sourcebots/kit-manufacture-2019/quote-pack/motor/motor-coords.txt

Filename: ...

Position of PCB:
left under edge: X=0 / Y=0

name	X-axis	Y-axis	angle	value	package	side
D12	30.62	70.05	0	gsot24c	SOT23	top
D11	41.48	70.05	180	gsot24c	SOT23	top
DS9	16.10	71.75	180	redblue-dual	0805_split_led	top
DS8	55.90	71.75	180	redblue-dual	0805_split_led	top
DS7	36.05	54.60	0	redgreen-0805	0805_led	top
R35	52.00	70.90	0	10k	0603	top
R21	31.50	54.65	180	1k-1206	1206	top
R53	12.70	71.15	180	1k-1206	1206	top
R37	59.30	71.15	0	1k-1206	1206	top
J7	22.90	74.00	180	camcon2w-5mm	camcon_50_2	top
J6	49.10	74.00	180	camcon2w-5mm	camcon_50_2	top
C39	16.00	42.00	270	pcf1c221mcl1gs	NICHICON_CAP_10_10	top
C37	44.00	42.00	270	pcf1c221mcl1gs	NICHICON_CAP_10_10	top
Q2	36.33	50.36	0	n-irfh5301	PQFN56B	top
C32	37.00	46.45	0	100n-0603-50v	0603	top
C40	28.00	42.00	270	pcf1c221mcl1gs	NICHICON_CAP_10_10	top
C38	56.00	42.00	270	pcf1c221mcl1gs	NICHICON_CAP_10_10	top
C31	36.00	67.15	180	100n-0603-50v	0603	top
L11	36.00	61.10	270	20a-170r	CM3440Z171B	top
J5	36.00	74.00	180	camcon2w	camcon_75_2	top
U6	20.00	60.09	90	vnh5019	MultiPowerSO30	top
U5	52.00	60.09	90	vnh5019	MultiPowerSO30	top
D10	26.53	16.85	180	gsot05c	SOT23	top
J2	29.59	21.08	270	header2x4-std	header_254_8w	top
DS2	41.80	64.35	90	red-0805	0805_led	top
DS3	41.80	59.00	90	blue-0805	0805_led	top
DS4	30.20	64.35	90	red-0805	0805_led	top
DS5	30.20	59.00	90	blue-0805	0805_led	top
S1	56.90	28.40	180	button-ra	FSMRA2JH	top
R13	16.15	35.30	180	10k-0402	0402	top
R16	26.05	29.10	270	10k-0402	0402	top
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
R15	30.50	16.50	270	4k7-0402	0402	top
L10	28.50	16.50	90	200m-1k-0402	0402	top
VR1	47.15	17.75	270	82400102	SOT26	top
R12	44.25	19.95	180	330-0402	0402	top
DS6	44.25	17.70	270	red-0805	0805_led	top
R1	42.25	19.95	180	330-0402	0402	top
DS1	42.25	17.70	270	green-0805	0805_led	top
C9	54.60	16.45	270	100n-0402-16v	0402	top
C20	53.60	16.45	270	100n-0402-16v	0402	top
C18	50.60	16.45	90	100n-0402-16v	0402	top
L3	49.60	16.45	270	200m-1k-0402	0402	top
R10	52.60	16.45	270	10k-0402	0402	top
R5	51.60	16.45	90	4k7-0402	0402	top
R38	40.80	28.10	0	10k-0402	0402	top
R40	40.80	32.20	180	4k7-0402	0402	top
R43	40.80	33.40	0	1k-0402	0402	top
R45	40.80	31.00	180	4k7-0402	0402	top
R46	40.80	29.80	0	1k-0402	0402	top
R24	40.80	25.70	180	4k7-0402	0402	top
R27	40.80	26.90	0	1k-0402	0402	top
R29	40.80	24.50	180	4k7-0402	0402	top
R30	40.80	23.30	0	1k-0402	0402	top
R54	40.80	34.60	0	10k-0402	0402	top
Y1	28.95	26.00	270	abmm2-8.000mhz-e2-t	ABMM2	top
J4	15.57	19.46	90	header2x5-1.27mm	header_127_10w	top
J1	46.00	13.01	270	usb-micro-b	FCI_10103592	top
FID1	11.00	17.00	0	unknown	FIDUCIAL	top
FID2	55.60	79.20	0	unknown	FIDUCIAL	top
