sourcebots/kit-manufacture-2019/quote-pack/motor/motor-coords-raw.txt

# PcbXY Version 1.0
# Date: Wed 10 Jul 2019 18:34:43 GMT UTC
# Author: Kier Davis
# Title: (unknown) - PCB X-Y
# RefDes, Description, Value, X, Y, rotation, top/bottom
# X,Y in mm.  rotation in degrees.
# --------------------------------------------
D12,"SOT23_sr.fp","sr-d-gsot24c",30.62,70.05,0,top
D11,"SOT23_sr.fp","sr-d-gsot24c",41.48,70.05,180,top
DS9,"0805_split_led_sr.fp","sr-led-redblue-dual",16.10,71.75,180,top
DS8,"0805_split_led_sr.fp","sr-led-redblue-dual",55.90,71.75,180,top
DS7,"0805_led_sr.fp","sr-led-redgreen-0805",36.05,54.60,0,top
R35,"0603_sr.fp","sr-r-10k",52.00,70.90,0,top
R21,"1206_sr.fp","sr-r-1k-1206",31.50,54.65,180,top
R53,"1206_sr.fp","sr-r-1k-1206",12.70,71.15,180,top
R37,"1206_sr.fp","sr-r-1k-1206",59.30,71.15,0,top
J7,"camcon_50_2_sr.fp","sr-cn-camcon2w-5mm",22.90,74.00,180,top
J6,"camcon_50_2_sr.fp","sr-cn-camcon2w-5mm",49.10,74.00,180,top
C39,"NICHICON_CAP_10_10_sr.fp","sr-c-pcf1c221mcl1gs",16.00,42.00,270,top
C37,"NICHICON_CAP_10_10_sr.fp","sr-c-pcf1c221mcl1gs",44.00,42.00,270,top
Q2,"PQFN56B_sr.fp","sr-fet-n-irfh5301",36.33,50.36,0,top
C32,"0603_sr.fp","sr-c-100n-0603-50v",37.00,46.45,0,top
C40,"NICHICON_CAP_10_10_sr.fp","sr-c-pcf1c221mcl1gs",28.00,42.00,270,top
C38,"NICHICON_CAP_10_10_sr.fp","sr-c-pcf1c221mcl1gs",56.00,42.00,270,top
C31,"0603_sr.fp","sr-c-100n-0603-50v",36.00,67.15,180,top
L11,"CM3440Z171B_sr.fp","sr-cm-20a-170r",36.00,61.10,270,top
J5,"camcon_75_2_sr.fp","sr-cn-camcon2w",36.00,74.00,180,top
U6,"MultiPowerSO30_sr.fp","sr-ic-vnh5019",20.00,60.09,90,top
U5,"MultiPowerSO30_sr.fp","sr-ic-vnh5019",52.00,60.09,90,top
D10,"SOT23_sr.fp","sr-d-gsot05c",26.53,16.85,180,top
J2,"header_254_8w_sr.fp","sr-cn-header2x4-std",29.59,21.08,270,top
DS2,"0805_led_sr.fp","sr-led-red-0805",41.80,64.35,90,top
DS3,"0805_led_sr.fp","sr-led-blue-0805",41.80,59.00,90,top
DS4,"0805_led_sr.fp","sr-led-red-0805",30.20,64.35,90,top
DS5,"0805_led_sr.fp","sr-led-blue-0805",30.20,59.00,90,top
S1,"FSMRA2JH_sr.fp","sr-sw-button-ra",56.90,28.40,180,top
R13,"0402_sr.fp","sr-r-10k-0402",16.15,35.30,180,top
R16,"0402_sr.fp","sr-r-10k-0402",26.05,29.10,270,top
C28,"0402_sr.fp","sr-c-100n-0402-16v",25.05,28.40,90,top
U4,"LQFP64_10_sr.fp","sr-ic-stm32f100r6",17.90,28.10,180,top
J3,"camcon_38_4_sr.fp","sr-cn-minicamcon4w",26.00,14.00,90,top
C35,"0603_sr.fp","sr-c-100n-0603-50v",25.80,48.95,0,top
C36,"1206_sr.fp","sr-c-10u-1206-16v",30.05,51.15,90,top
C33,"0603_sr.fp","sr-c-100n-0603-50v",57.80,48.95,0,top
C34,"1206_sr.fp","sr-c-10u-1206-16v",41.80,51.15,90,top
C48,"0603_sr.fp","sr-c-100n-0603-50v",24.00,70.90,0,top
R51,"0603_sr.fp","sr-r-10k",20.00,70.90,0,top
C44,"0603_sr.fp","sr-c-100n-0603-50v",48.00,70.90,0,top
D15,"SOT23_sr.fp","sr-d-bat754a",36.00,39.08,270,top
R58,"0402_sr.fp","sr-r-10k-0402",34.50,46.70,0,top
R59,"0402_sr.fp","sr-r-10k-0402",37.00,41.25,0,top
Q3,"SOT23_sr.fp","sr-npn-bc846b",36.00,44.08,270,top
R60,"0402_sr.fp","sr-r-10k-0402",35.00,41.25,0,top
U3,"QFN32_5_EP_sr.fp","sr-ic-ft232rq",54.85,20.50,270,top
C1,"0805_sr.fp","sr-c-4u7-0805-10v",59.85,17.95,180,top
C19,"0603_sr.fp","sr-c-47n-0603-50v",52.15,11.85,270,top
R9,"0402_sr.fp","sr-r-1000k-0402",52.15,14.35,90,top
C11,"0402_sr.fp","sr-c-100n-0402-16v",51.35,18.35,270,top
C7,"0402_sr.fp","sr-c-100n-0402-16v",59.10,22.95,0,top
C21,"0402_sr.fp","sr-c-100n-0402-16v",19.20,16.35,270,top
L6,"0402_sr.fp","sr-fb-200m-1k-0402",18.20,16.35,90,top
F1,"1206_sr.fp","sr-fuse-r50-1206",22.10,16.35,0,top
D2,"SOD123_sr.fp","sr-d-mmsz4689t1g",54.05,12.70,270,top
D1,"SOT23_sr.fp","sr-d-bat754c",59.52,20.60,0,top
C13,"0402_sr.fp","sr-c-100n-0402-16v",35.70,10.85,0,top
C17,"0402_sr.fp","sr-c-10n-0402-25v",49.90,17.90,0,top
Q1,"SOT23_sr.fp","sr-npn-bc846b",59.62,34.05,0,top
C26,"0603_sr.fp","sr-c-470n-0603-25v",57.45,34.15,90,top
C12,"0805_sr.fp","sr-c-4u7-0805-10v",23.40,19.25,270,top
C10,"0402_sr.fp","sr-c-100n-0402-16v",21.90,20.10,270,top
C8,"0402_sr.fp","sr-c-100n-0402-16v",10.70,23.65,90,top
C6,"0402_sr.fp","sr-c-100n-0402-16v",14.25,35.30,0,top
C5,"0402_sr.fp","sr-c-100n-0402-16v",20.45,35.30,0,top
C16,"0603_sr.fp","sr-c-1u-0603-16v",26.05,33.55,90,top
C15,"0402_sr.fp","sr-c-100n-0402-16v",25.05,30.30,270,top
L5,"0402_sr.fp","sr-fb-200m-1k-0402",39.50,20.05,0,top
L4,"0402_sr.fp","sr-fb-200m-1k-0402",37.60,20.05,0,top
C14,"0402_sr.fp","sr-c-100n-0402-16v",35.70,20.05,0,top
C29,"0402_sr.fp","sr-c-27p-0402-50v",32.85,26.65,270,top
C30,"0402_sr.fp","sr-c-27p-0402-50v",25.05,24.60,270,top
R17,"0402_sr.fp","sr-r-100-0402",25.05,26.50,270,top
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
R38,"0402_sr.fp","sr-r-10k-0402",40.80,28.10,0,top
R40,"0402_sr.fp","sr-r-4k7-0402",40.80,32.20,180,top
R43,"0402_sr.fp","sr-r-1k-0402",40.80,33.40,0,top
R45,"0402_sr.fp","sr-r-4k7-0402",40.80,31.00,180,top
R46,"0402_sr.fp","sr-r-1k-0402",40.80,29.80,0,top
R24,"0402_sr.fp","sr-r-4k7-0402",40.80,25.70,180,top
R27,"0402_sr.fp","sr-r-1k-0402",40.80,26.90,0,top
R29,"0402_sr.fp","sr-r-4k7-0402",40.80,24.50,180,top
R30,"0402_sr.fp","sr-r-1k-0402",40.80,23.30,0,top
R54,"0402_sr.fp","sr-r-10k-0402",40.80,34.60,0,top
Y1,"ABMM2_sr.fp","sr-xtal-abmm2-8.000mhz-e2-t",28.95,26.00,270,top
J4,"header_127_10w_sr.fp","sr-cn-header2x5-1.27mm",15.57,19.46,90,top
J1,"FCI_10103592_sr.fp","sr-cn-usb-micro-b",46.00,13.01,270,top
FID1,"FIDUCIAL_sr.fp","unknown",11.00,17.00,0,top
FID2,"FIDUCIAL_sr.fp","unknown",55.60,79.20,0,top
