sourcebots/kit-manufacture-2019/quote-pack/motor/motor.txt

## Specifications ##

Substrate: 1.6mm FR4
Num layers: 4
Copper weight: 1oz
Finish: HASL
Soldermask: top and bottom
Soldermask colour: green
Silkscreen: top and bottom
Silkscreen colour: white
Quantity: 16 boards
Dimensions: 52mm x 70mm

Layer stackup:
  Top (motor.top.gbr)
  Inner 1 (motor.group2.gbr)
  Inner 2 (motor.group3.gbr)
  Bottom (motor.bottom.gbr)

Number of surface mount components: 156
Number of through-hole components: 8

Number of types of component / BOM lines: 59

## Components Of Note ##

D14, R2, R3, R11: do not populate (unused)
