sourcebots/kit-manufacture-2019/quote-pack/servo/servo.txt

## Specifications ##

Substrate: 1.6mm FR4
Num layers: 4
Copper weight: 1oz
Finish: HASL
Soldermask: top and bottom
Soldermask colour: green
Silkscreen: top and bottom
Silkscreen colour: white
Quantity: 25 boards
Dimensions: 50mm x 51mm

Layer stackup:
  Top (servo.top.gbr)
  Inner 1 (servo.group2.gbr)
  Inner 2 (servo.group3.gbr)
  Bottom (servo.bottom.gbr)

Number of surface mount components: 139
Number of through-hole components: 7

Number of types of component / BOM lines: 55

## Components Of Note ##

N/A
