sourcebots/kit-manufacture-2019/quote-pack/servo/servo-bom.xlsx

Part | Value | Device | Package | Description | Description2 | Qty | Place_YES/NO | Provided_by_customer_YES/NO | Distributor | Ordernumber | Weblink | Remarks_customer | Unit_price | Total_price | REMARKS_BETA | OPTION1 | OPTION2 | OPTION3
C19, C4, C5, C8, C7, C38, C31, C40, C12, C18, C39, C32, C3 | 100n-0402-16v | sr-c-100n-0402-16v | 0402 | SMD Capacitor, 100nF, 10%, 16V, 0402 |  | 13 | YES | NO | beta
C21, C34, C14 | 100n-0603-50v | sr-c-100n-0603-50v | 0603 | SMD Capacitor, 100nF, 10%, 50V, 0603 |  | 3 | YES | NO | beta
C11 | 10n-0402-25v | sr-c-10n-0402-25v | 0402 | SMD Capacitor, 10nF, 10%, 25V, 0402 |  | 1 | YES | NO | beta
C9, C30, C10, C35 | 1n5-0402-50v | sr-c-1n5-0402-50v | 0402 | 1n5 capacitor 0402 50V X7R |  | 4 | YES | NO | farnell | 1758993 | https://uk.farnell.com/-/-/-/dp/1758993
C13, C1, C37, C2, C22 | 1u-0402-10v | sr-c-1u-0402-10v | 0402 | 1u capacitor 0402 10V X5R |  | 5 | YES | NO | farnell | 1458896 | https://uk.farnell.com/-/-/-/dp/1458896
C20 | 1u-0603-16v | sr-c-1u-0603-16v | 0603 | SMD Capacitor, 1uF, 10%, 16V, 0603 |  | 1 | YES | NO | beta
C44, C43, C6 | 22u-0805-10v | sr-c-22u-0805-10v | 0805 | 22u capacitor 0805 10V X5R |  | 3 | YES | NO | farnell | 2611932 | https://uk.farnell.com/-/-/-/dp/2611932
C42, C33, C41, C25, C23, C24 | 22u-1210-16v | sr-c-22u-1210-16v | 1210 | 22u ceramic capacitor 1210 16V X5R |  | 6 | YES | NO | farnell | 1759466 | https://uk.farnell.com/-/-/-/dp/1759466
C15, C16 | 27p-0402-50v | sr-c-27p-0402-50v | 0402 | 27p capacitor 0402 50V C0G/NP0 |  | 2 | YES | NO | farnell | 1414584 | https://uk.farnell.com/-/-/-/dp/1414584
C17 | 470n-0603-25v | sr-c-470n-0603-25v | 0603 | 470n capacitor 0603 25V X7R |  | 1 | YES | NO | farnell | 1856365 | https://uk.farnell.com/-/-/-/dp/1856365
C26, C29, C28, C27 | 47u-1206-6v3 | sr-c-47u-1206-6v3 | 1206 | 47u ceramic capacitor 1206 6.3V X5R |  | 4 | YES | NO | mouser | 81-GRT31CR61A476KE3L | https://www.mouser.co.uk/ProductDetail/Murata-Electronics/GRT31CR61A476KE13L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
J4 | camcon2w | sr-cn-camcon2w | camcon_75_2 | Pluggable terminal block 2way 7.5mm pitch male horiz |  | 1 | YES | NO | farnell | 3882391 | https://uk.farnell.com/-/-/-/dp/3882391
J5 | camcon2w-5mm | sr-cn-camcon2w-5mm | camcon_50_2 | Pluggable terminal block 2way 5mm pitch male horiz |  | 1 | YES | NO | farnell | 3882093 | https://uk.farnell.com/-/-/-/dp/3882093
J3 | header2x5-1.27mm | sr-cn-header2x5-1.27mm | header_127_10w | 2x5 through-hole 1.27mm header 3mm pin length |  | 1 | YES | NO | farnell | 1577743 | https://uk.farnell.com/-/-/-/dp/1577743
J6 | header3x4-ra | sr-cn-header3x4-ra | header_254_3_12w | 3x4 through-hole 2.54mm right angle header |  | 1 | YES | NO | farnell | 2053141 | https://uk.farnell.com/-/-/-/dp/2053141
J7 | header3x8-ra | sr-cn-header3x8-ra | header_254_3_24w | 3x8 through-hole 2.54mm right angle header |  | 1 | YES | NO | farnell | 2053145 | https://uk.farnell.com/-/-/-/dp/2053145
J1 | minicamcon4w | sr-cn-minicamcon4w | camcon_38_4 | Pluggable terminal block 4way 3.81mm pitch male horiz |  | 1 | YES | NO | farnell | 1717073 | https://uk.farnell.com/-/-/-/dp/1717073
J2 | usb-micro-b | sr-cn-usb-micro-b | FCI_10103592 | Micro USB B connector for top mounting |  | 1 | YES | NO | farnell | 2490660 | https://uk.farnell.com/-/-/-/dp/2490660
D2 | 1sma5918bt3g | sr-d-1sma5918bt3g | DO214AC | zener diode 5.1V 1.5W |  | 1 | YES | NO | farnell | 1431140 | https://uk.farnell.com/-/-/-/dp/1431140
D4, D1 | bat54c | sr-d-bat54c | SOT23 | schottky diode 30V 300mA dual common cathode |  | 2 | YES | NO | farnell | 9801499 | https://uk.farnell.com/-/-/-/dp/9801499
D7, D9, D10 | edz51v | sr-d-edz51v | SOD523 | zener diode 5.1V 150mW |  | 3 | YES | NO | farnell | 2536475 | https://uk.farnell.com/-/-/-/dp/2536475
D15, D13, D18, D3, D14, D17, D12 | mmbz15val | sr-d-mmbz15val | SOT23 | 12V unidirectional dual TVS diode 40W common anode |  | 7 | YES | NO | farnell | 1829193 | https://uk.farnell.com/-/-/-/dp/1829193
D11, D5, D16 | pesd5z12 | sr-d-pesd5z12 | SOD523 | 12V unidirectional TVS diode 200W |  | 3 | YES | NO | farnell | 1829227 | https://uk.farnell.com/-/-/-/dp/1829227
D6, D8 | smaj15ca | sr-d-smaj15ca | DO214AC | 15V bidirectional TVS diode 400W |  | 2 | YES | NO | farnell | 9802789 | https://uk.farnell.com/-/-/-/dp/9802789
L2, L4, L3 | 200m-1k-0402 | sr-fb-200m-1k-0402 | 0402 | 200mA 1k @ 100MHz 0402 |  | 3 | YES | NO | farnell | 1669673 | https://uk.farnell.com/-/-/-/dp/1669673
L1, L5 | 300m-0603 | sr-fb-300m-0603 | 0603 | 300mA 1k @ 100MHz 0603 |  | 2 | YES | NO | farnell | 1463451 | https://uk.farnell.com/-/-/-/dp/1463451
Q6 | n-bsh121 | sr-fet-n-bsh121 | SOT323 | BSH121 n-channel mosfet very low Vt of 1V |  | 1 | YES | NO | farnell | 2053836 | https://uk.farnell.com/-/-/-/dp/2053836
Q4, Q5, Q3, Q2 | p-si7655adn | sr-fet-p-si7655adn | PowerPAK1212 | p-channel mosfet 20V 30A |  | 4 | YES | NO | farnell | 2400368 | https://uk.farnell.com/-/-/-/dp/2400368
F1 | r200-1206 | sr-fuse-r200-1206 | 1206 | 200mA 30V resettable fuse |  | 1 | YES | NO | farnell | 1206716 | https://uk.farnell.com/-/-/-/dp/1206716
U6 | ina219 | sr-ic-ina219 | SOT28 | INA219AIDCNR I2C current sense amp |  | 1 | YES | NO | farnell | 3118164 | https://uk.farnell.com/-/-/-/dp/3118164
U1 | mcp1700t3302emb | sr-ic-mcp1700t3302emb | SOT89 | 3.3V 250mA (6V Vin max) linear voltage reg |  | 1 | YES | NO | farnell | 1439380 | https://uk.farnell.com/-/-/-/dp/1439380
U4 | mcp1703t5002emb | sr-ic-mcp1703t5002emb | SOT89 | 5V 250mA (16V Vin max) linear voltage reg |  | 1 | YES | NO | farnell | 1851953 | https://uk.farnell.com/-/-/-/dp/1851953
U7 | mcp23017ess | sr-ic-mcp23017ess | SSOP28 | 16bit I2C I/O expander |  | 1 | YES | NO | farnell | 1467674 | https://uk.farnell.com/-/-/-/dp/1467674
U5 | pvx012a0x3 | sr-ic-pvx012a0x3 | PVX012A0X3 | 3V-14.4V input 0.6V-5.5V output 12A non-isolated DC-DC module |  | 1 | YES | NO | farnell | 2076909 | https://uk.farnell.com/-/-/-/dp/2076909
U8 | si8602ac | sr-ic-si8602ac | SOIC8 | 3.75kV I2C isolator with unidirectional SCL |  | 1 | YES | NO | mouser | 634-SI8602AC-B-IS | https://www.mouser.co.uk/ProductDetail/Silicon-Labs/SI8602AC-B-IS?qs=j6MGy4L9yX00K7b%252BnoTSPA%3D%3D
U3 | stf202 | sr-ic-stf202 | SOT26 | USB EMI/ESD protection and termination |  | 1 | YES | NO | mouser | 863-STF202-22T1G | https://www.mouser.co.uk/ProductDetail/ON-Semiconductor/STF202-22T1G
U2 | stm32f103c6u | sr-ic-stm32f103c6u | QFN48_5_EP | STM32F103C6 32bit mcu 32k flash 10k ram |  | 1 | YES | NO | farnell | 2333160 | https://uk.farnell.com/-/-/-/dp/2333160
U2 | stm32f103c6u | sr-ic-stm32f103c6u | QFN48_5_EP | STM32F103C6 32bit mcu 32k flash 10k ram |  | 1 | YES | NO | mouser | 511-STM32F103C6U6A | https://www.mouser.co.uk/ProductDetail/STMicroelectronics/STM32F103C6U6A
DS11, DS6, DS12, DS7, DS2, DS14, DS13, DS9, DS3, DS8, DS4, DS5 | blue-0805 | sr-led-blue-0805 | 0805_led | LED 0805 Blue |  | 12 | YES | NO | farnell | 2217974 | https://uk.farnell.com/-/-/-/dp/2217974
DS15, DS16, DS1 | green-0805 | sr-led-green-0805 | 0805_led | LED 0805 Green |  | 3 | YES | NO | farnell | 1318243 | https://uk.farnell.com/-/-/-/dp/1318243
DS10 | redblue-dual | sr-led-redblue-dual | 0805_split_led | Dual LED Red/Blue |  | 1 | YES | NO | farnell | 1686083 | https://uk.farnell.com/-/-/-/dp/1686083
Q7, Q1 | bc846b | sr-npn-bc846b | SOT23 | BC846B NPN BJT 65V 100mA |  | 2 | YES | NO | farnell | 1081229 | https://uk.farnell.com/-/-/-/dp/1081229
R21, R19 | 10-0402 | sr-r-10-0402 | 0402 | SMD Resistor, 10ohm, 1%, 62.5mW, 0402 |  | 2 | YES | NO | beta
R4, R1, R8, R5 | 100-0402 | sr-r-100-0402 | 0402 | SMD Resistor, 100ohm, 1%, 62.5mW, 0402 |  | 4 | YES | NO | beta
R6 | 1000k-0402 | sr-r-1000k-0402 | 0402 | SMD Resistor, 1Mohm, 1%, 62.5mW, 0402 |  | 1 | YES | NO | beta
R24, R23, R15, R27, R32, R13, R12, R17, R14, R25, R7, R11, R28, R31, R22 | 10k-0402 | sr-r-10k-0402 | 0402 | SMD Resistor, 10kohm, 1%, 62.5mW, 0402 |  | 15 | YES | NO | beta
R9, R26, R10 | 1k-0402 | sr-r-1k-0402 | 0402 | SMD Resistor, 1kohm, 1%, 62.5mW, 0402 |  | 3 | YES | NO | beta
R20 | 2k49-0402 | sr-r-2k49-0402 | 0402 | 2k49 0402 chip resistor 1% |  | 1 | YES | NO | farnell | 2072829 | https://uk.farnell.com/-/-/-/dp/2072829
R16 | 330-0402 | sr-r-330-0402 | 0402 | SMD Resistor, 330ohm, 1%, 62.5mW, 0402 |  | 1 | YES | NO | beta
R30, R33, R29 | 390-0402 | sr-r-390-0402 | 0402 | SMD Resistor, 390ohm, 1%, 62.5mW, 0402 |  | 3 | YES | NO | beta
R18 | 3m-1210-1w | sr-r-3m-1210-1w | 1210 | 3m 1210 chip resistor 1W 50ppm |  | 1 | YES | NO | farnell | 1621964 | https://uk.farnell.com/-/-/-/dp/1621964
R3, R2 | 4k7-0402 | sr-r-4k7-0402 | 0402 | SMD Resistor, 4.7kohm, 1%, 62.5mW, 0402 |  | 2 | YES | NO | beta
RN3, RN2, RN1 | 4-100-0402 | sr-ra-4-100-0402 | CAY10J4 | 4pack of 100R resistors 0804 (0402 equiv) |  | 3 | YES | NO | farnell | 3228722 | https://uk.farnell.com/-/-/-/dp/3228722
RN5, RN4, RN6 | 4-330-0402 | sr-ra-4-330-0402 | CAY10J4 | 4pack of 330R resistors 0804 (0402 equiv) |  | 3 | YES | NO | farnell | 1770150 | https://uk.farnell.com/-/-/-/dp/1770150
S1 | button-ra | sr-sw-button-ra | FSMRA2JH | FSMRA2JH Right angle tactile button |  | 1 | YES | NO | farnell | 1555987 | https://uk.farnell.com/-/-/-/dp/1555987
Y1 | abmm2-8.000mhz-e2-t | sr-xtal-abmm2-8.000mhz-e2-t | ABMM2 | 8MHz Crystal 20ppm |  | 1 | YES | NO | farnell | 1611803 | https://uk.farnell.com/-/-/-/dp/1611803
