sourcebots/kit-manufacture-2019/quote-pack/motor/motor-bom.xlsx

Part | Value | Device | Package | Description | Description2 | Qty | Place_YES/NO | Provided_by_customer_YES/NO | Distributor | Ordernumber | Weblink | Remarks_customer | Unit_price | Total_price | REMARKS_BETA | OPTION1 | OPTION2 | OPTION3
C13, C5, C11, C8, C20, C7, C10, C6, C14, C21, C28, C27, C18, C15, C9 | 100n-0402-16v | sr-c-100n-0402-16v | 0402 | SMD Capacitor, 100nF, 10%, 16V, 0402 |  | 15 | YES | NO | beta
C44, C33, C31, C32, C48, C35 | 100n-0603-50v | sr-c-100n-0603-50v | 0603 | SMD Capacitor, 100nF, 10%, 50V, 0603 |  | 6 | YES | NO | beta
C17 | 10n-0402-25v | sr-c-10n-0402-25v | 0402 | SMD Capacitor, 10nF, 10%, 25V, 0402 |  | 1 | YES | NO | beta
C34, C36 | 10u-1206-16v | sr-c-10u-1206-16v | 1206 | SMD Capacitor, 10uF, 10%, 16V, 1206 |  | 2 | YES | NO | beta
C25, C24 | 1n-0402-50v | sr-c-1n-0402-50v | 0402 | SMD Capacitor, 1nF, 10%, 50V, 0402 |  | 2 | YES | NO | beta
C22, C16 | 1u-0603-16v | sr-c-1u-0603-16v | 0603 | SMD Capacitor, 1uF, 10%, 16V, 0603 |  | 2 | YES | NO | beta
C50 | 220n-0402-16v | sr-c-220n-0402-16v | 0402 | SMD Capacitor, 220nF, 10%, 16V, 0402 |  | 1 | YES | NO | beta
C52, C4 | 22u-0805-6v3 | sr-c-22u-0805-6v3 | 0805 | 22u capacitor 0805 6.3V X5R |  | 2 | YES | NO | farnell | 1867955 | https://uk.farnell.com/-/-/-/dp/1867955
C30, C29 | 27p-0402-50v | sr-c-27p-0402-50v | 0402 | 27p capacitor 0402 50V C0G/NP0 |  | 2 | YES | NO | farnell | 1414584 | https://uk.farnell.com/-/-/-/dp/1414584
C3, C23 | 2u2-1206-50v | sr-c-2u2-1206-50v | 1206 | 2u2 capacitor 1206 50V X7R |  | 2 | YES | NO | farnell | 2688488 | https://uk.farnell.com/-/-/-/dp/2688488
C47, C43, C42, C49, C51, C41, C45, C46 | 33n-0402-25v | sr-c-33n-0402-25v | 0402 | 33n capacitor 0402 25V X7R |  | 8 | YES | NO | farnell | 2627357 | https://uk.farnell.com/-/-/-/dp/2627357
C26 | 470n-0603-25v | sr-c-470n-0603-25v | 0603 | 470n capacitor 0603 25V X7R |  | 1 | YES | NO | farnell | 1856365 | https://uk.farnell.com/-/-/-/dp/1856365
C19, C2 | 47n-0603-50v | sr-c-47n-0603-50v | 0603 | SMD Capacitor, 47nF, 10%, 50V, 0603 |  | 2 | YES | NO | beta
C1, C12 | 4u7-0805-10v | sr-c-4u7-0805-10v | 0805 | SMD Capacitor, 4.7uF, 10%, 10V (25V is suitable), 0805 |  | 2 | YES | NO | beta
C39, C38, C40, C37 | pcf1c221mcl1gs | sr-c-pcf1c221mcl1gs | NICHICON_CAP_10_10 | 220u capacitor smt electrolytic 16V 3.9A ripple |  | 4 | YES | NO | mouser | 647-PCF1C221MCL1GS | https://www.mouser.co.uk/ProductDetail/Nichicon/PCF1C221MCL1GS?qs=PCEjGSkOlsZtS692W1YdaQ%3D%3D
L11 | 20a-170r | sr-cm-20a-170r | CM3440Z171B | 20A through-hole cm choke 170R at 100MHz |  | 1 | YES | NO | mouser | 875-CM3440Z171B-10 | https://www.mouser.co.uk/ProductDetail/Laird-Performance-Materials/CM3440Z171B-10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
J5 | camcon2w | sr-cn-camcon2w | camcon_75_2 | Pluggable terminal block 2way 7.5mm pitch male horiz |  | 1 | YES | NO | rapid | 21-2448 | https://www.rapidonline.com/Catalogue/Search?Query=21-2448 | low stock (want 172, while only 227 are available)
J6, J7 | camcon2w-5mm | sr-cn-camcon2w-5mm | camcon_50_2 | Pluggable terminal block 2way 5mm pitch male horiz |  | 2 | YES | NO | farnell | 3882093 | https://uk.farnell.com/-/-/-/dp/3882093
J2 | header2x4-std | sr-cn-header2x4-std | header_254_8w | 2x4 through-hole 2.54mm header – 6mm pin length |  | 1 | YES | NO | farnell | 1022233 | https://uk.farnell.com/-/-/-/dp/1022233
J4 | header2x5-1.27mm | sr-cn-header2x5-1.27mm | header_127_10w | 2x5 through-hole 1.27mm header 3mm pin length |  | 1 | YES | NO | farnell | 1577743 | https://uk.farnell.com/-/-/-/dp/1577743
J3 | minicamcon4w | sr-cn-minicamcon4w | camcon_38_4 | CTB93HE/4 – Pluggable terminal block 4way 3.81mm pitch male horiz |  | 1 | YES | NO | farnell | 1717073 | https://uk.farnell.com/-/-/-/dp/1717073
J1 | usb-micro-b | sr-cn-usb-micro-b | FCI_10103592 | Micro USB B connector for top mounting |  | 1 | YES | NO | farnell | 2490660 | https://uk.farnell.com/-/-/-/dp/2490660
VR1 | 82400102 | sr-d-82400102 | SOT26 | Wurth 82400102 dual TVS diode array |  | 1 | YES | NO | farnell | 1825875 | https://uk.farnell.com/-/-/-/dp/1825875
D15 | bat754a | sr-d-bat754a | SOT23 | Schottky diode dual |  | 1 | YES | NO | farnell | 1081204 | https://uk.farnell.com/-/-/-/dp/1081204
D13, D1 | bat754c | sr-d-bat754c | SOT23 | schottky diode dual |  | 2 | YES | NO | farnell | 1081205 | https://uk.farnell.com/-/-/-/dp/1081205
D6, D7, D4, D9, D8 | bat754s | sr-d-bat754s | SOT23 | schottky diode dual |  | 5 | YES | NO | farnell | 1081206 | https://uk.farnell.com/-/-/-/dp/1081206
D5 | bzx384c3v3 | sr-d-bzx384c3v3 | SOD323 | zener diode 3.3V 5% |  | 1 | YES | NO | farnell | 8735646 | https://uk.farnell.com/-/-/-/dp/8735646
D10 | gsot05c | sr-d-gsot05c | SOT23 | 5V unidirectional dual TVS diode 480W common anode |  | 1 | YES | NO | farnell | 2433345 | https://uk.farnell.com/-/-/-/dp/2433345
D11, D12 | gsot24c | sr-d-gsot24c | SOT23 | 24V unidirectional dual TVS diode 325W common anode |  | 2 | YES | NO | mouser | 511-ESDA25LY | https://www.mouser.co.uk/ProductDetail/STMicroelectronics/ESDA25LY?qs=hKcDQsDv3HY%252BMeYV0LkHOw%3D%3D
D2 | mmsz4689t1g | sr-d-mmsz4689t1g | SOD123 | zener diode 5.1V 500mW |  | 1 | YES | NO | farnell | 1459121 | https://uk.farnell.com/-/-/-/dp/1459121
D3 | smaj15ca | sr-d-smaj15ca | DO214AC | 15V bidirectional TVS diode 400W |  | 1 | YES | NO | farnell | 9802789 | https://uk.farnell.com/-/-/-/dp/9802789
L4, L5, L10, L7, L6, L2, L8, L9, L1, L3 | 200m-1k-0402 | sr-fb-200m-1k-0402 | 0402 | 200mA 1k @ 100MHz 0402 |  | 10 | YES | NO | farnell | 1669673 | https://uk.farnell.com/-/-/-/dp/1669673
Q2 | n-irfh5301 | sr-fet-n-irfh5301 | PQFN56B | IRFH5301PBF n-channel mosfet 35A |  | 1 | YES | NO | farnell | 2580009 | https://uk.farnell.com/-/-/-/dp/2580009
F1 | r50-1206 | sr-fuse-r50-1206 | 1206 | 50mA 60V resettable fuse |  | 1 | YES | NO | mouser | 530-0ZCJ0005FF2E | https://www.mouser.co.uk/ProductDetail/Bel-Fuse/0ZCJ0005FF2E?qs=SRYZG9HaIQ1a%252BL7Aij5U%252BA%3D%3D
U2 | adum3211arz | sr-ic-adum3211arz | SOIC8_bypass | ADUM3211ARZ 2.5kV 10Mbps dual bi-directional isolator |  | 1 | YES | NO | mouser | 584-ADUM3211ARZ | https://www.mouser.co.uk/ProductDetail/Analog-Devices/ADUM3211ARZ?qs=WIvQP4zGanjmCKq0qik6cQ%3D%3D
U3 | ft232rq | sr-ic-ft232rq | QFN32_5_EP | FT232RQ USB to UART |  | 1 | YES | NO | farnell | 1146033 | https://uk.farnell.com/-/-/-/dp/1146033
U1 | lmr14203 | sr-ic-lmr14203 | SOT26 | LMR14203XMK step-down DC/DC converter 42V 0.3A |  | 1 | YES | NO | mouser | 926-LMR14203XMK/NOPB | https://www.mouser.co.uk/ProductDetail/Texas-Instruments/LMR14203XMK-NOPB?qs=cN01o9PeIQtwRl0XgRtw9A%3D%3D
U4 | stm32f100r8 | sr-ic-stm32f100r8 | LQFP64_10 | STM32F100R8 32bit mcu 64k flash 8k ram |  | 1 | YES | NO | farnell | 1838508 | https://uk.farnell.com/-/-/-/dp/1838508
U5, U6 | vnh5019 | sr-ic-vnh5019 | MultiPowerSO30 | VNH5019A-E 30A H-Bridge |  | 2 | YES | NO | mouser | 511-VNH5019ATR-E | https://www.mouser.co.uk/ProductDetail/STMicroelectronics/VNH5019ATR-E?qs=T%2FOtf55vL7cDceYVZzSNKw%3D%3D
L12 | 68u-900ma | sr-l-68u-900ma | SRN6045 | 68u 0.9A smt inductor |  | 1 | YES | NO | mouser | 652-SRN6045-680M | https://www.mouser.co.uk/ProductDetail/Bourns/SRN6045-680M?qs=opBjA1TV901hnn5hEQBljw%3D%3D
DS3, DS5 | blue-0805 | sr-led-blue-0805 | 0805_led | LED 0805 Blue |  | 2 | YES | NO | farnell | 2217974 | https://uk.farnell.com/-/-/-/dp/2217974
DS1 | green-0805 | sr-led-green-0805 | 0805_led | LED 0805 Green |  | 1 | YES | NO | farnell | 1318243 | https://uk.farnell.com/-/-/-/dp/1318243
DS4, DS6, DS2 | red-0805 | sr-led-red-0805 | 0805_led | LED 0805 Red |  | 3 | YES | NO | farnell | 8529949 | https://uk.farnell.com/-/-/-/dp/8529949
DS9, DS8 | redblue-dual | sr-led-redblue-dual | 0805_split_led | Dual LED Red/Blue |  | 2 | YES | NO | farnell | 1686083 | https://uk.farnell.com/-/-/-/dp/1686083
DS7 | redgreen-0805 | sr-led-redgreen-0805 | 0805_led | Bi-Colour LED Red/Green 0805 |  | 1 | YES | NO | tme | KPB-2012SURKCGKC | https://www.tme.eu/en/details/KPB-2012SURKCGKC
Q3, Q1 | bc846b | sr-npn-bc846b | SOT23 | BC846B NPN BJT 65V 100mA |  | 2 | YES | NO | farnell | 1081229 | https://uk.farnell.com/-/-/-/dp/1081229
R17 | 100-0402 | sr-r-100-0402 | 0402 | SMD Resistor, 100ohm, 1%, 62.5mW, 0402 |  | 1 | YES | NO | beta
R9 | 1000k-0402 | sr-r-1000k-0402 | 0402 | SMD Resistor, 1Mohm, 1%, 62.5mW, 0402 |  | 1 | YES | NO | beta
R35, R51 | 10k | sr-r-10k | 0603 | SMD Resistor, 10kohm, 1%, 62.5mW, 0603 |  | 2 | YES | NO | beta
R59, R20, R10, R16, R57, R58, R13, R19, R60, R54, R32, R38, R48, R18 | 10k-0402 | sr-r-10k-0402 | 0402 | SMD Resistor, 10kohm, 1%, 62.5mW, 0402 |  | 14 | YES | NO | beta
R44, R43, R27, R46, R47, R30, R52, R28, R31, R36 | 1k-0402 | sr-r-1k-0402 | 0402 | SMD Resistor, 1kohm, 1%, 62.5mW, 0402 |  | 10 | YES | NO | beta
R21, R53, R37 | 1k-1206 | sr-r-1k-1206 | 1206 | SMD Resistor, 1kohm, 1%, 250mW, 1206 |  | 3 | YES | NO | beta
R42, R26, R23, R50, R55, R34, R39 | 1k1-0402 | sr-r-1k1-0402 | 0402 | SMD Resistor, 1.1kohm, 1%, 62.5mW, 0402 |  | 7 | YES | NO | beta
R6, R4, R1, R12, R8, R7 | 330-0402 | sr-r-330-0402 | 0402 | SMD Resistor, 330ohm, 1%, 62.5mW, 0402 |  | 6 | YES | NO | beta
R56 | 33k2-0402 | sr-r-33k2-0402 | 0402 | 33k2 0402 chip resistor 1% |  | 1 | YES | NO | farnell | 2072936 | https://uk.farnell.com/-/-/-/dp/2072936
R49, R33, R41, R25, R22 | 4k3-0402 | sr-r-4k3-0402 | 0402 | 4k3 0402 chip resistor 1% |  | 5 | YES | NO | farnell | 2447185 | https://uk.farnell.com/-/-/-/dp/2447185
R24, R15, R5, R14, R29, R40, R45 | 4k7-0402 | sr-r-4k7-0402 | 0402 | SMD Resistor, 4.7kohm, 1%, 62.5mW, 0402 |  | 7 | YES | NO | beta
S1 | button-ra | sr-sw-button-ra | FSMRA2JH | FSMRA2JH Right angle tactile button |  | 1 | YES | NO | farnell | 1555987 | https://uk.farnell.com/-/-/-/dp/1555987
Y1 | abmm2-8.000mhz-e2-t | sr-xtal-abmm2-8.000mhz-e2-t | ABMM2 | 8MHz Crystal 20ppm |  | 1 | YES | NO | farnell | 1611803 | https://uk.farnell.com/-/-/-/dp/1611803
