sourcebots/kit-manufacture-2019/quote-pack/power/power-bom.xlsx

Part | Value | Device | Package | Description | Description2 | Qty | Place_YES/NO | Provided_by_customer_YES/NO | Distributor | Ordernumber | Weblink | Remarks_customer | Unit_price | Total_price | REMARKS_BETA | OPTION1 | OPTION2 | OPTION3
C47, C44, C56, C4, C43, C63, C51, C27, C41, C39, C50, C35, C17, C24, C58, C33, C12, C54, C34, C32, C8, C49, C28, C37, C52, C25, C62, C5, C29, C38, C31, C40, C15, C57, C48 | 100n-0402-16v | sr-c-100n-0402-16v | 0402 | SMD Capacitor, 100nF, 10%, 16V, 0402 |  | 35 | YES | NO | beta
C59, C1 | 100n-0603-50v | sr-c-100n-0603-50v | 0603 | SMD Capacitor, 100nF, 10%, 50V, 0603 |  | 2 | YES | NO | beta
C22, C45, C46 | 10n-0402-25v | sr-c-10n-0402-25v | 0402 | SMD Capacitor, 10nF, 10%, 25V, 0402 |  | 3 | YES | NO | beta
C19 | 10p-0402-50v | sr-c-10p-0402-50v | 0402 | SMD Capacitor, 10pF, 10%, 50V, 0402 |  | 1 | YES | NO | beta
C26, C13, C30, C42, C7, C14, C36, C3 | 10u-1206-16v | sr-c-10u-1206-16v | 1206 | SMD Capacitor, 10uF, 10%, 16V, 1206 |  | 8 | YES | NO | beta
C55, C23, C6 | 1u-0402-10v | sr-c-1u-0402-10v | 0402 | SMD Capacitor, 1uF, 10%, 10V (16V is suitable), 0402 |  | 3 | YES | NO | beta
C53, C20, C10, C21, C18, C9, C16 | 22u-0805-10v | sr-c-22u-0805-10v | 0805 | 22u capacitor 0805 10V X5R |  | 7 | YES | NO | farnell | 2611932 | https://uk.farnell.com/-/-/-/dp/2611932
C60, C61 | 27p-0402-50v | sr-c-27p-0402-50v | 0402 | 27p capacitor 0402 50V C0G/NP0 |  | 2 | YES | NO | farnell | 1414584 | https://uk.farnell.com/-/-/-/dp/1414584
C2 | ucw1e471mnl1gs | sr-c-ucw1e471mnl1gs | NICHICON_CAP_10_10 | 470u capacitor smt electrolytic 25V 850mA ripple |  | 1 | YES | NO | rs | 715-1708 | https://uk.rs-online.com/web/p/-/7151708/
J13, J11, J10, J9, J12, J8 | camcon2w | sr-cn-camcon2w | camcon_75_2 | Pluggable terminal block 2way 7.5mm pitch male horiz |  | 6 | YES | NO | rapid | 21-2448 | https://www.rapidonline.com/Catalogue/Search?Query=21-2448 | low stock (want 172, while only 227 are available)
J4 | camcon2w-5mm | sr-cn-camcon2w-5mm | camcon_50_2 | Pluggable terminal block 2way 5mm pitch male horiz |  | 1 | YES | NO | farnell | 3882093 | https://uk.farnell.com/-/-/-/dp/3882093
J17 | header2x5-1.27mm | sr-cn-header2x5-1.27mm | header_127_10w | 2x5 through-hole 1.27mm header 3mm pin length |  | 1 | YES | NO | farnell | 1577743 | https://uk.farnell.com/-/-/-/dp/1577743
J14 | header6 | sr-cn-header6 | header_254_1_6w | 6Way header 1 row header |  | 1 | YES | NO | farnell | 1593415 | https://uk.farnell.com/-/-/-/dp/1593415
J6, J7, J15 | minicamcon2w | sr-cn-minicamcon2w | camcon_38_2 | Pluggable terminal block 2way 3.81mm pitch male horiz |  | 3 | YES | NO | farnell | 3704725 | https://uk.farnell.com/-/-/-/dp/3704725
J16 | usb-micro-b | sr-cn-usb-micro-b | FCI_10103592 | Micro USB B connector for top mounting |  | 1 | YES | NO | farnell | 2490660 | https://uk.farnell.com/-/-/-/dp/2490660
D13 | bat754c | sr-d-bat754c | SOT23 | schottky diode dual |  | 1 | YES | NO | farnell | 1081205 | https://uk.farnell.com/-/-/-/dp/1081205
D4 | bzx384c3v3 | sr-d-bzx384c3v3 | SOD323 | zener diode 3.3V 5% |  | 1 | YES | NO | farnell | 8735646 | https://uk.farnell.com/-/-/-/dp/8735646
D3, D14, D15 | mmbz15val | sr-d-mmbz15val | SOT23 | 12V unidirectional dual TVS diode 40W common anode |  | 3 | YES | NO | farnell | 1829193 | https://uk.farnell.com/-/-/-/dp/1829193
D6 | mmsz4689t1g | sr-d-mmsz4689t1g | SOD123 | zener diode 5.1V 500mW |  | 1 | YES | NO | farnell | 1459121 | https://uk.farnell.com/-/-/-/dp/1459121
D16, D11, D2, D7, D9, D17, D8, D10, D12 | pesd5z12 | sr-d-pesd5z12 | SOD523 | 12V unidirectional TVS diode 200W |  | 9 | YES | NO | farnell | 1829227 | https://uk.farnell.com/-/-/-/dp/1829227
D1 | smaj15ca | sr-d-smaj15ca | DO214AC | 15V bidirectional TVS diode 400W |  | 1 | YES | NO | farnell | 9802789 | https://uk.farnell.com/-/-/-/dp/9802789
D5 | smaj5.0a | sr-d-smaj5.0a | DO214AC | 5V unidirectional TVS diode 400W |  | 1 | YES | NO | farnell | 1815679 | https://uk.farnell.com/-/-/-/dp/1815679
L3 | 200m-1k-0402 | sr-fb-200m-1k-0402 | 0402 | 200mA 1k @ 100MHz 0402 |  | 1 | YES | NO | farnell | 1669673 | https://uk.farnell.com/-/-/-/dp/1669673
Q5, Q3, Q4 | n-bsh121 | sr-fet-n-bsh121 | SOT323 | BSH121 n-channel mosfet very low Vt of 1V |  | 3 | YES | NO | farnell | 2053836 | https://uk.farnell.com/-/-/-/dp/2053836
Q1, Q2 | n-irfh5301 | sr-fet-n-irfh5301 | PQFN56B | IRFH5301PBF n-channel mosfet 35A |  | 2 | YES | NO | farnell | 2580009 | https://uk.farnell.com/-/-/-/dp/2580009
F2, F3 | r125-1206 | sr-fuse-r125-1206 | 1206 | 125mA 30V resettable fuse |  | 2 | YES | NO | farnell | 1596988 | https://uk.farnell.com/-/-/-/dp/1596988
F4 | r1850-2920 | sr-fuse-r1850-2920 | 2920 | 1.85A 33V resettable fuse |  | 1 | YES | NO | farnell | 1822228 | https://uk.farnell.com/-/-/-/dp/1822228
U1, U4 | ina219 | sr-ic-ina219 | SOT28 | INA219AIDCNR I2C current sense amp |  | 2 | YES | NO | farnell | 2295989 | https://uk.farnell.com/-/-/-/dp/2295989
U9 | mcp9701at | sr-ic-mcp9701at | SC70_5 | Temperature sensor |  | 1 | YES | NO | farnell | 1627203 | https://uk.farnell.com/-/-/-/dp/1627203
U11 | stf202 | sr-ic-stf202 | SOT26 | USB EMI/ESD protection and termination |  | 1 | YES | NO | mouser | 863-STF202-22T1G | https://www.mouser.co.uk/ProductDetail/ON-Semiconductor/STF202-22T1G?qs=xZq1yRCsb1dM1UQ1NtNRtw%3D%3D
U10 | stm32f103r6 | sr-ic-stm32f103r6 | LQFP64_10 | STM32F103R6 32bit mcu 32k flash 10k ram |  | 1 | YES | NO | farnell | 1899014 | https://uk.farnell.com/-/-/-/dp/1899014
U3 | tps54327drc | sr-ic-tps54327drc | SON10 | TPS54327DRC step-down DC/DC converter synchronous 18V 3A |  | 1 | YES | NO | mouser | 595-TPS54327DRCT | https://www.mouser.co.uk/ProductDetail/Texas-Instruments/TPS54327DRCT?qs=ZLZ8689ywa01bV%252B3s%2FYwYA%3D%3D
U2 | tps62125dsg | sr-ic-tps62125dsg | SON8 | TPS62125DSG step-down DC/DC converter synchronous 17V 300mA |  | 1 | YES | NO | mouser | 595-TPS62125DSGT | https://www.mouser.co.uk/ProductDetail/Texas-Instruments/TPS62125DSGT?qs=5771e39Rz9GnhiZFg6wlxw%3D%3D
U5, U7, U8, U6 | vnd5012 | sr-ic-vnd5012 | PowerSSO24 | VND5012AK-E 12mR dual MOSFET |  | 4 | YES | NO | mouser | 511-VND5012AKTR-E | https://www.mouser.co.uk/ProductDetail/STMicroelectronics/VND5012AKTR-E?qs=u5uFzNBi3h7HDblUXA%252BtLw%3D%3D
L1 | 22u-380ma | sr-l-22u-380ma | TYS252012L | 22u 380mA smt inductor |  | 1 | YES | NO | mouser | 875-TYS252012L220M10 | https://www.mouser.co.uk/ProductDetail/Laird-Performance-Materials/TYS252012L220M-10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
L2 | 3u3-3000ma | sr-l-3u3-3000ma | MPI4040 | 3.3u inductor 3A |  | 1 | YES | NO | mouser | 520-MPI4040R3-3R3-R | https://www.mouser.co.uk/ProductDetail/ECS/ECS-MPI4040R3-3R3-R?qs=5aG0NVq1C4xxA5h6ALenvw%3D%3D
DS2 | green-0805 | sr-led-green-0805 | 0805_led | LED 0805 Green |  | 1 | YES | NO | farnell | 1318243 | https://uk.farnell.com/-/-/-/dp/1318243
DS6, DS1, DS7, DS9, DS3, DS8, DS4, DS5 | redgreen-dual | sr-led-redgreen-dual | 0805_split_led | Dual LED Red/Green |  | 8 | YES | NO | farnell | 1686079 | https://uk.farnell.com/-/-/-/dp/1686079
X1 | pkm13epy-4000-a0 | sr-piezo-pkm13epy-4000-a0 | PKM13EPYH4000 | THT 12.6mm piezo sounder |  | 1 | YES | NO | farnell | 1192513 | https://uk.farnell.com/-/-/-/dp/1192513
R3, R4, R17, R18 | 10-0402 | sr-r-10-0402 | 0402 | SMD Resistor, 10ohm, 1%, 62.5mW, 0402 |  | 4 | YES | NO | beta
R67, R72, R10, R69, R73, R66, R65, R63, R71, R68, R70 | 100-0402 | sr-r-100-0402 | 0402 | SMD Resistor, 100ohm, 1%, 62.5mW, 0402 |  | 11 | YES | NO | beta
R58 | 1000k-0402 | sr-r-1000k-0402 | 0402 | SMD Resistor, 1Mohm, 1%, 62.5mW, 0402 |  | 1 | YES | NO | beta
R42, R16, R54, R59, R6, R43, R23, R37, R62, R56, R30, R53, R5, R32, R64, R22, R36, R15, R47, R25, R29, R74 | 10k-0402 | sr-r-10k-0402 | 0402 | SMD Resistor, 10kohm, 1%, 62.5mW, 0402 |  | 22 | YES | NO | beta
R14 | 10m-0805 | sr-r-10m-0805 | 0805 | 10m 0805 chip resistor |  | 1 | YES | NO | farnell | 8067643 | https://uk.farnell.com/-/-/-/dp/8067643
R20 | 150k-0402 | sr-r-150k-0402 | 0402 | SMD Resistor, 150kohm, 1%, 62.5mW, 0402 |  | 1 | YES | NO | beta
R9 | 180k-0402 | sr-r-180k-0402 | 0402 | SMD Resistor, 180kohm, 1%, 62.5mW, 0402 |  | 1 | YES | NO | beta
R61, R49, R60, R75, R50, R48 | 1k-0402 | sr-r-1k-0402 | 0402 | SMD Resistor, 1kohm, 1%, 62.5mW, 0402 |  | 6 | YES | NO | beta
R21, R46, R35, R41, R28, R38 | 1k-0805 | sr-r-1k-0805 | 0805 | SMD Resistor, 1kohm, 1%, 125mW, 0805 |  | 6 | YES | NO | beta
R1, R2 | 1m-2512-1w | sr-r-1m-2512-1w | 2512 | 1m 2512 1W 50ppm |  | 2 | YES | NO | farnell | 1292474 | https://uk.farnell.com/-/-/-/dp/1292474
R19 | 200-0402 | sr-r-200-0402 | 0402 | 200 0402 chip resistor 1% |  | 1 | YES | NO | farnell | 2072751 | https://uk.farnell.com/-/-/-/dp/2072751
R26, R27, R33, R40, R34, R39 | 3k3-0402 | sr-r-3k3-0402 | 0402 | SMD Resistor, 3.3kohm, 1%, 62.5mW, 0402 |  | 6 | YES | NO | beta
R7 | 4700k-0402 | sr-r-4700k-0402 | 0402 | 4.7M 0402 chip resistor 1% |  | 1 | YES | NO | farnell | 2447191 | https://uk.farnell.com/-/-/-/dp/2447191
R24, R57, R55, R52, R31 | 4k7-0402 | sr-r-4k7-0402 | 0402 | SMD Resistor, 4.7kohm, 1%, 62.5mW, 0402 |  | 5 | YES | NO | beta
R44, R45 | 560-0402 | sr-r-560-0402 | 0402 | SMD Resistor, 560ohm, 1%, 62.5mW, 0402 |  | 2 | YES | NO | beta
R8 | 576k-0402 | sr-r-576k-0402 | 0402 | 576k 0402 chip resistor 1% |  | 1 | YES | NO | mouser | 603-RC0402FR-07576KL | https://www.mouser.co.uk/ProductDetail/Yageo/RC0402FR-07576KL?qs=Is6ZsIPfHkbSfhU6fqkhSA%3D%3D
R13, R12 | 57k6-0402 | sr-r-57k6-0402 | 0402 | 57.6k 0402 chip resistor 1% |  | 2 | YES | NO | farnell | 2073148 | https://uk.farnell.com/-/-/-/dp/2073148
R11 | 64k9-0402 | sr-r-64k9-0402 | 0402 | 64.9k 0402 chip resisotr 1% |  | 1 | YES | NO | farnell | 2073190 | https://uk.farnell.com/-/-/-/dp/2073190
R51 | 680-1206 | sr-r-680-1206 | 1206 | SMD Resistor, 680ohm, 1%, 500mW, 1206 |  | 1 | YES | NO | beta
RN3, RN1 | 4-10k-0402 | sr-ra-4-10k-0402 | CAY10J4 | 4pack of 10k resistors 0804 (0402 equiv) |  | 2 | YES | NO | farnell | 9235418 | https://uk.farnell.com/-/-/-/dp/9235418
RN2 | 4-4k7-0402 | sr-ra-4-4k7-0402 | CAY10J4 | 4pack of 4k7 resistors 0804 (0402 equiv) |  | 1 | YES | NO | farnell | 1770151 | https://uk.farnell.com/-/-/-/dp/1770151
S1 | spph410100 | sr-sw-spph410100 | SPPH4 | DPST vertical latching push button |  | 1 | YES | NO | farnell | 1435768 | https://uk.farnell.com/-/-/-/dp/1435768
S2 | spph410200 | sr-sw-spph410200 | SPPH4 | DPST vertical non-latching push button |  | 1 | YES | NO | farnell | 1435769 | https://uk.farnell.com/-/-/-/dp/1435769
Y1 | abmm2-8.000mhz-e2-t | sr-xtal-abmm2-8.000mhz-e2-t | ABMM2 | 8MHz Crystal 20ppm |  | 1 | YES | NO | farnell | 1611803 | https://uk.farnell.com/-/-/-/dp/1611803
