sourcebots/kit-manufacture-2019/(threads)

Thread 4 (2019-02-04):

Generate final gerbers

kierdavis, 2019-02-04:
- [x] Resolve #1
- [x] Ensure gerbers have been regenerated

Closed 2019-02-11.

Thread 6 (2019-02-04):

Write manufacturing specification

kierdavis, 2019-02-04:
* PCB specs
* Unusual components
  * Fan
  * Press-fit connectors
  * Unpopulated pads
  * TODO: check for more...

Closed 2019-02-11.

Thread 7 (2019-02-04):

Quote pack

kierdavis, 2019-02-04:
- [x] Gerbers (#4)
- [x] Placement diagrams (#5)
- [x] Board BOMs (#2)
- [ ] ~~Combined BOM (#3)~~
- [x] Manufacturing specification (#6)

Closed 2019-02-18.

Thread 10 (2019-02-18):

Get quote from Beta Layout

kierdavis, 2019-02-18:
https://uk.beta-layout.com/

kierdavis, 2019-03-09:
[Online price calculator](https://uk.beta-layout.com/pcb/configurator/) gives the following estimate:

| Board | Quantity | PCB cost | Assembly cost | Total cost |
| --- | --- | --- | --- | --- |
| power | 17 boards | €246.87 (~£213.16) | €1419.59 (~£1225.75) | €1666.46 (~£1438.91) |
| motor | 16 boards | €216.66 (~£187.08) | €1124.07 (~£970.58) | €1340.73 (~£1157.66) |
| servo | 25 boards | €237.42 (~£205.00) | €1170.24 (~£1010.45) | €1407.66 (~£1215.45) |

Grand total €4414.85 (~£3812.02) excluding component costs.

All prices include VAT.

kierdavis, 2019-03-09:
I have also sent off an inquiry for the power board, will do the other two boards at a later date.

kierdavis, 2019-03-11:
The power boards will be made as a special order due to the presence of press-fit components. I presume this would make them more expensive.

I've asked for them to quote for both including and excluding the press-fit component.

kierdavis, 2019-03-13:
They've said that if the press-fit parts are excluded the best option is to use the online PCB-Pool service (same thing as the price calculator used above). The numbers in the table above are indeed wrong (they're for a 2-layer board not a 4-layer board) - I'll fix them later.

If they are included, the order will be done as a special order. They're concerned that no tolerance on the size of the pins of these press-fit components appears to be given on their [datasheet](http://www.farnell.com/datasheets/1736660.pdf).

kierdavis, 2019-05-27:
Updated quote: [betalayout.pdf](https://github.com/sourcebots/kit-manufacture-2019/files/3224342/betalayout.pdf)

| Board | Quantity | PCB cost | Assembly cost | Total cost |
| --- | --- | --- | --- | --- |
| power | 17 boards | €562.17 (~£496.38) | €1340.89 (~£1184.27) | €1903.06 (~£1680.78) |
| motor | 16 boards | €404.92 (~£357.63) | €1124.07 (~£992.72) | €1528.99 (~£1350.33) |
| servo | 25 boards | €450.87 (~£398.19) | €1170.24 (~£1033.56) | €1621.11 (~£1431.77) |

Grand total €5053.16 (~£4462.98) excluding component costs.

All prices include VAT.

kierdavis, 2019-05-27:
I've added this to a comparison spreadsheet [here](https://docs.google.com/spreadsheets/d/1zE_gw8idO3K-fdvhHla8w_M4fcu3P_LFyxQ6oa0C2X4/edit).

Closed 2019-05-27.

Thread 11 (2019-02-18):

Get quote from MyRO

kierdavis, 2019-02-18:
http://www.myropcb.com/

kierdavis, 2019-03-09:
I have emailed the quote pack to `sales@myropcb.com`.

kierdavis, 2019-03-11:
| Board | Quantity | PCB cost | Components cost | Assembly cost | Total cost |
| --- | --- | --- | --- | --- | --- |
| power | 17 boards | $282.70 | $2079.23 | $1019.93 | $3381.86 |
| motor | 16 boards | $264.52 | $1053.18 | $831.16 | $2148.86 |
| servo | 25 boards | $277.50 | $1546.51 | $964.98 | $2788.99 |

Grand total: $8319.71, including components, excluding VAT and import duty.

The assembly fees appear to include an IC programming fee to the tune of ~$200 per type of board. I will ask them to remove this because we can easily do this step ourselves.

kierdavis, 2019-05-27:
I've added this to a comparison spreadsheet [here](https://docs.google.com/spreadsheets/d/1zE_gw8idO3K-fdvhHla8w_M4fcu3P_LFyxQ6oa0C2X4/edit).

It's been a couple months since we got the quote, so we would probably have to resubmit and get an updated one if we were to make a purchase.

Closed 2019-05-27.

Thread 12 (2019-03-09):

Get quote from Express Circuits

kierdavis, 2019-03-09:
https://www.express-circuits.co.uk/pcb-assembly.php

kierdavis, 2019-03-09:
I have emailed the quote pack to their assembly enquiries address.

kierdavis, 2019-10-23:
I never heard back and we went with a different supplier in the end.

Closed 2019-10-23.

Thread 13 (2019-03-12):

Get quote from Garner Osborne

kierdavis, 2019-03-12:
https://www.garnerosborne.co.uk/contact/

They produced all of Student Robotics' V4 boards, so they might still have the designs on file.

Possibly of use:
- SR trac tickets for purchasing these boards: [power](https://studentrobotics.org/trac/ticket/2564), [motor](https://studentrobotics.org/trac/ticket/1830), [servo](https://studentrobotics.org/trac/ticket/2565)
- The quotes they got back from Garner Osborne: [power](https://studentrobotics.org/trac/raw-attachment/ticket/2564/PBv4B_quote.pdf), [motor](https://studentrobotics.org/trac/raw-attachment/ticket/1766/E58324-%20Student%20Robotics.pdf), [servo](https://studentrobotics.org/trac/raw-attachment/ticket/2565/SBv4B_quote.pdf)

Unfortunately, authentication with a Student Robotics volunteer account is required to access these links.

kierdavis, 2019-05-27:
I've emailed their sales address, including reference to the original SR quotes.

kierdavis, 2019-06-05:
They have a query about one of the components that has gone out of stock (sr-led-redblue-dual / KPHBM2012PBASURKC). It's out of stock on every distributor I can find. APHBM2012LQBDSURKC looks like a suitable replacement but it's only available from ["Future Electronics"](https://www.futureelectronics.com/p/3090343).

kierdavis, 2019-10-23:
We went with a different supplier in the end.

Closed 2019-10-23.
