sourcebots/kit-manufacture-2019/quote-pack/motor/motor-schematic.pdf

# Reverse

# Power

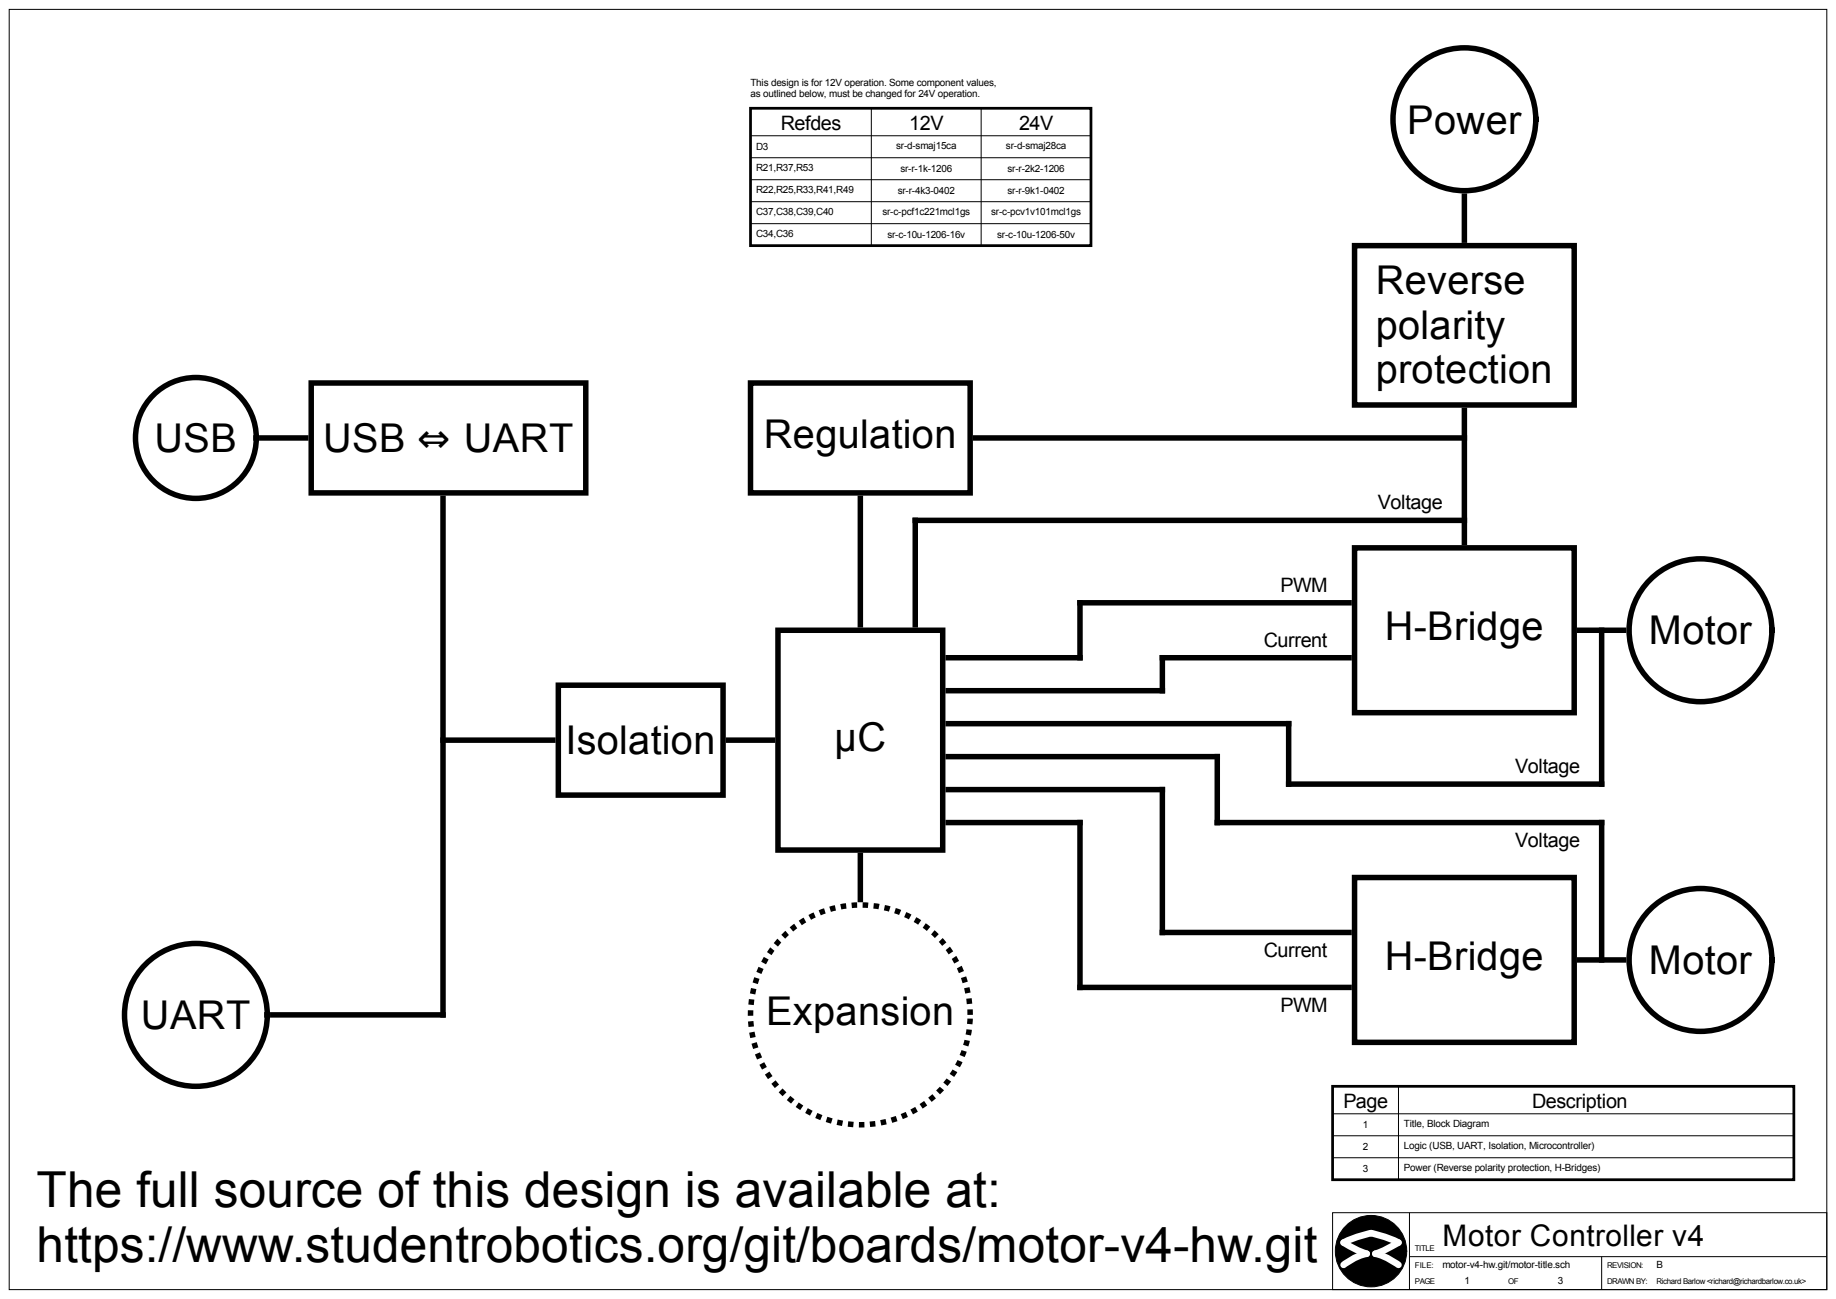
[picture p1: page 1]
FILE:; REVISION:; PAGE; DRAWN BY:; Richard Barlow <richard@richardbarlow.co.uk>; Page; Description; USB; USB ⇔ UART; UART; Isolation; Expansion; H-Bridge; Motor; PWM; Current; Voltage; Regulation; polarity protection; Refdes; sr-d-smaj15ca; sr-c-pcf1c221mcl1gs; sr-d-smaj28ca; sr-c-pcv1v101mcl1gs

This design is for 12V operation. Some component values,
as outlined below, must be changed for 24V operation.

Title, Block Diagram

Logic (USB, UART, Isolation, Microcontroller)

Power (Reverse polarity protection, H-Bridges) The full source of this design is available at:
https://www.studentrobotics.org/git/boards/motor-v4-hw.git

TITLE Motor Controller v4

motor-v4-hw.git/motor-title.sch

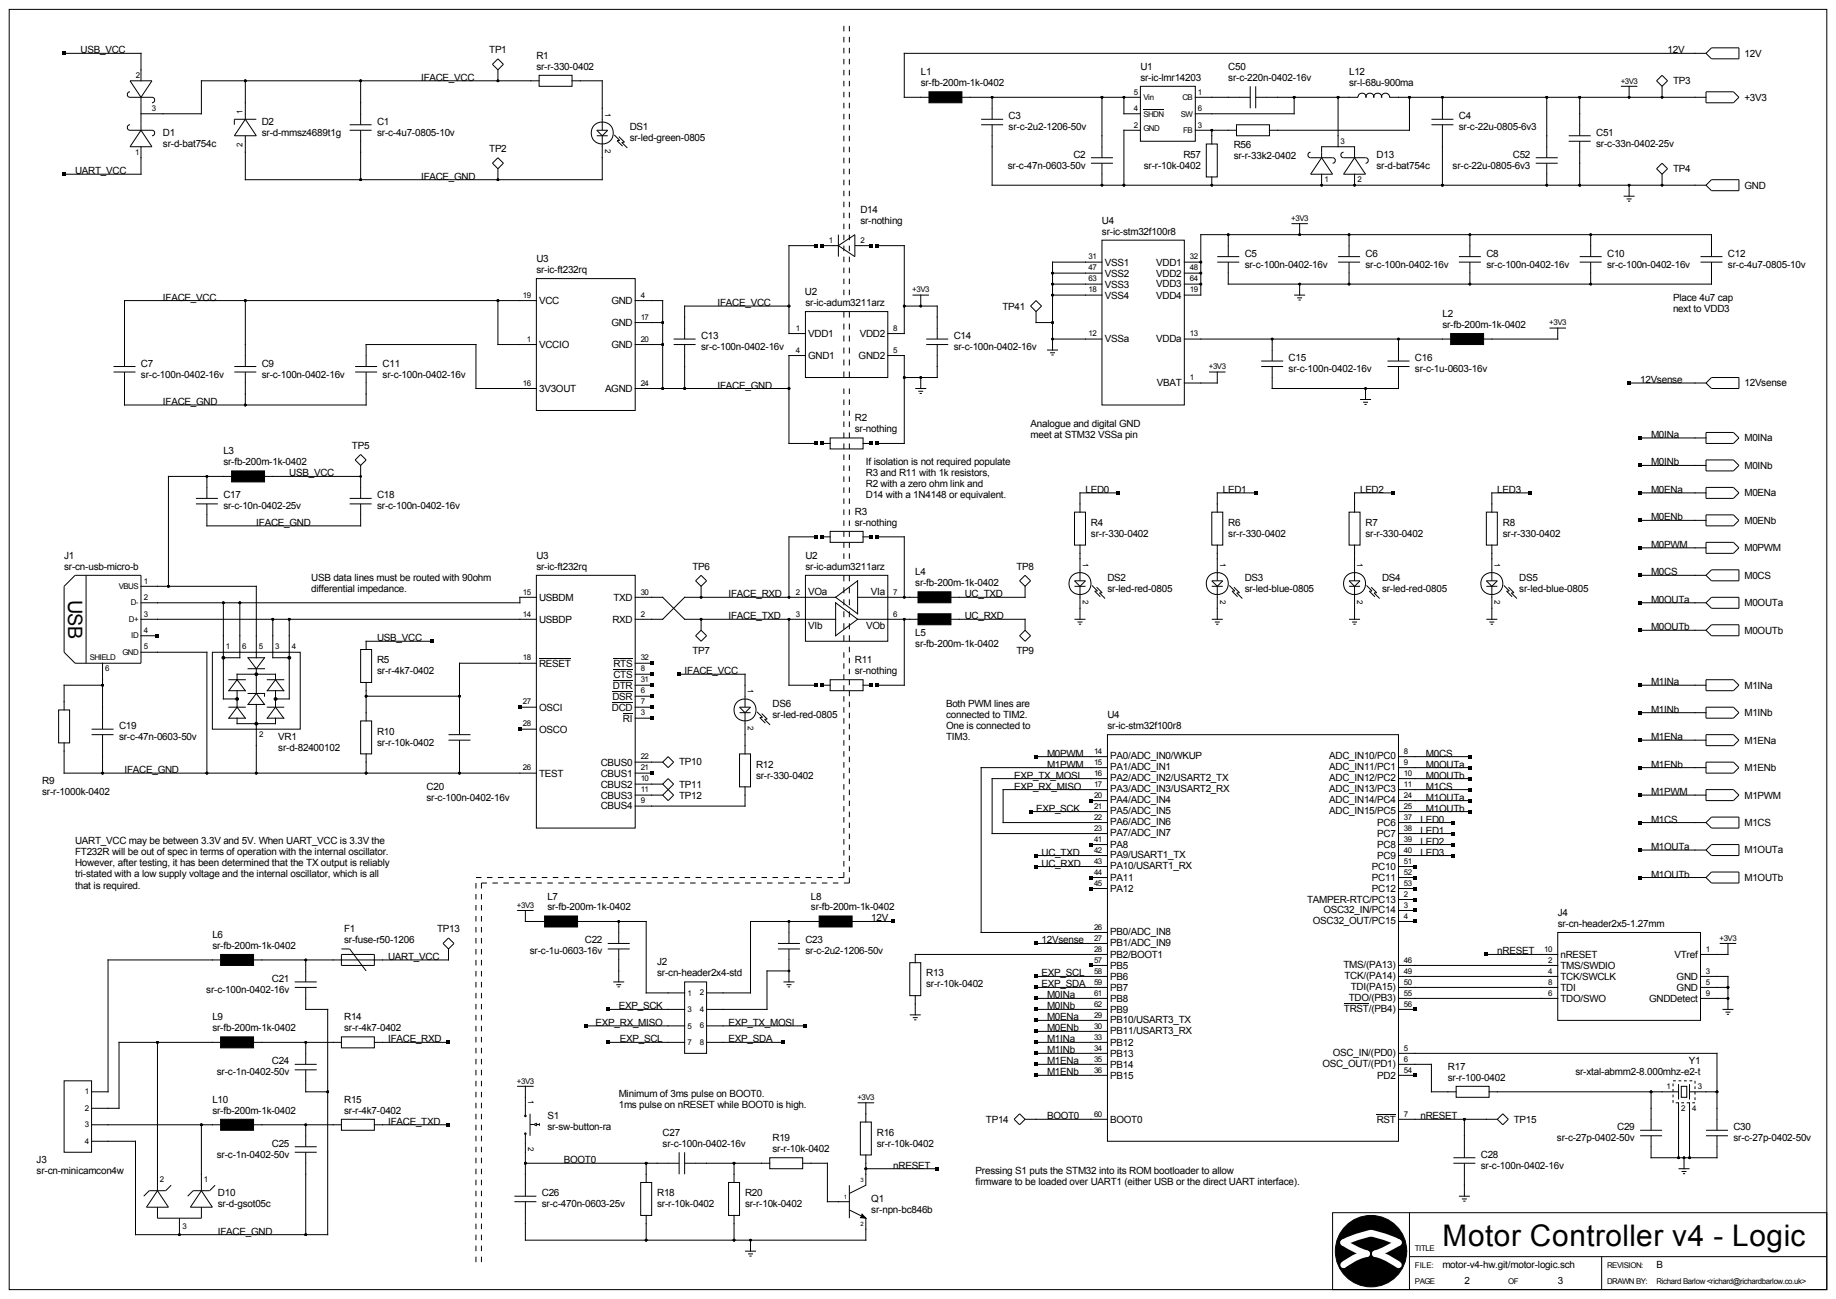
[picture p2: page 2]

Analogue and digital GND
meet at STM32 VSSa pin

If isolation is not required populate
R3 and R11 with 1k resistors,
R2 with a zero ohm link and
D14 with a 1N4148 or equivalent.
sr-nothing

USB J1
sr-cn-usb-micro-b

USB data lines must be routed with 90ohm
differential impedance.

Both PWM lines are
connected to TIM2.
One is connected to
TIM3.

UART_VCC may be between 3.3V and 5V. When UART_VCC is 3.3V the
FT232R will be out of spec in terms of operation with the internal oscillator.
However, after testing, it has been determined that the TX output is reliably
tri-stated with a low supply voltage and the internal oscillator, which is all
that is required.

Minimum of 3ms pulse on BOOT0.
1ms pulse on nRESET while BOOT0 is high.

Pressing S1 puts the STM32 into its ROM bootloader to allow
firmware to be loaded over UART1 (either USB or the direct UART interface).

motor-v4-hw.git/motor-logic.sch

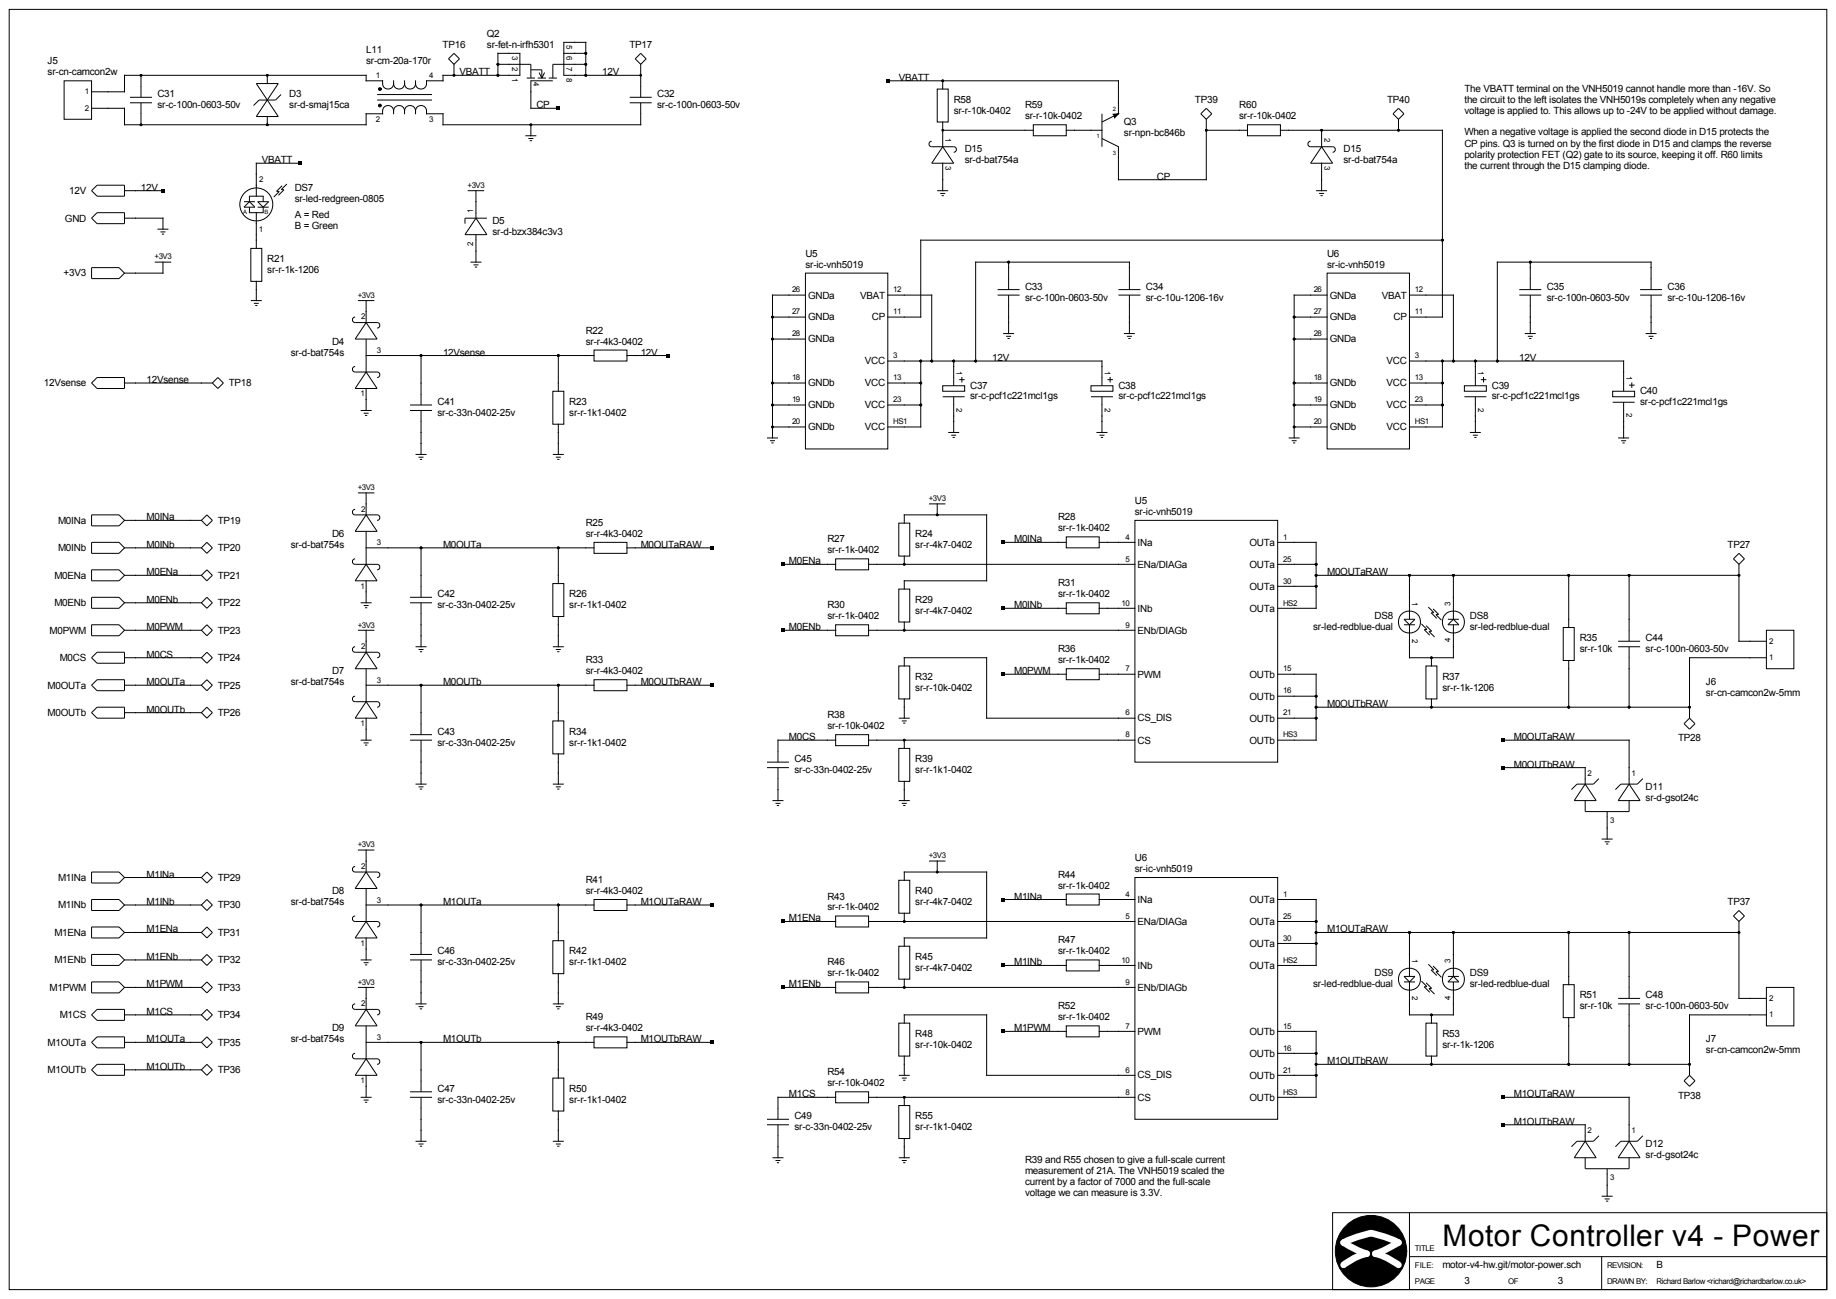
[picture p3: page 3]

The VBATT terminal on the VNH5019 cannot handle more than -16V. So
the circuit to the left isolates the VNH5019s completely when any negative
voltage is applied to. This allows up to -24V to be applied without damage.

When a negative voltage is applied the second diode in D15 protects the
CP pins. Q3 is turned on by the first diode in D15 and clamps the reverse
polarity protection FET (Q2) gate to its source, keeping it off. R60 limits
the current through the D15 clamping diode.

sr-led-redblue-dual

R39 and R55 chosen to give a full-scale current
measurement of 21A. The VNH5019 scaled the
current by a factor of 7000 and the full-scale
voltage we can measure is 3.3V.

TITLE Motor Controller v4 - Power

motor-v4-hw.git/motor-power.sch
