sourcebots/kit-manufacture-2019/quote-pack/power/power-schematic.pdf

# Battery

# Overcurrent

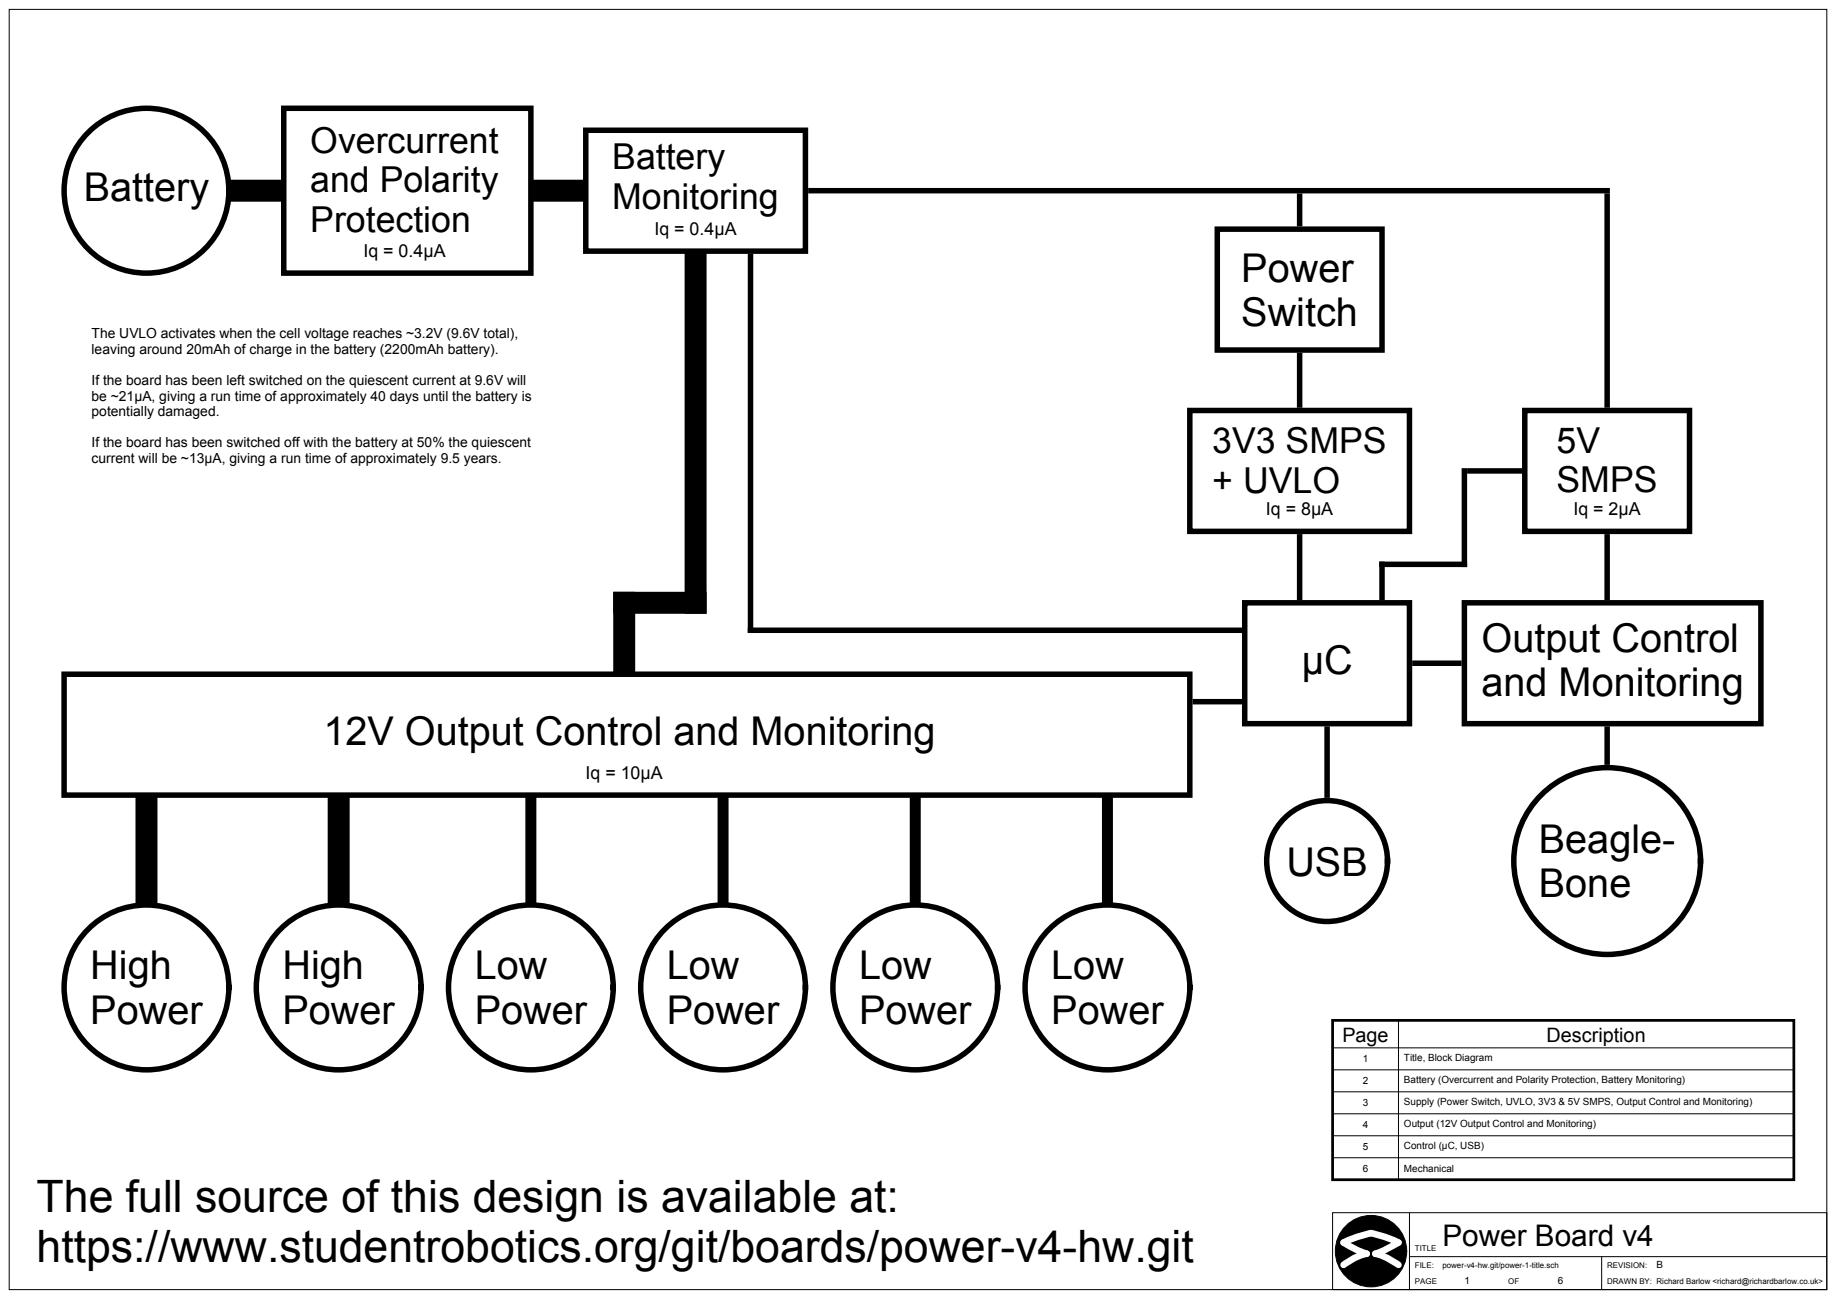
[picture p4: page 1]
FILE:; REVISION:; PAGE; DRAWN BY:; Richard Barlow <richard@richardbarlow.co.uk>; Page; Description; USB; and Polarity Protection; Battery Monitoring; Power Switch; 3V3 SMPS + UVLO; 5V SMPS; Output Control and Monitoring; High Power; Low Power; Beagle- Bone; Output (12V Output Control and Monitoring); Control (µC, USB); Mechanical

The UVLO activates when the cell voltage reaches ~3.2V (9.6V total),
leaving around 20mAh of charge in the battery (2200mAh battery).

If the board has been left switched on the quiescent current at 9.6V will
be ~21µA, giving a run time of approximately 40 days until the battery is
potentially damaged.

If the board has been switched off with the battery at 50% the quiescent
current will be ~13µA, giving a run time of approximately 9.5 years.

12V Output Control and Monitoring

Title, Block Diagram

Battery (Overcurrent and Polarity Protection, Battery Monitoring)

Supply (Power Switch, UVLO, 3V3 & 5V SMPS, Output Control and Monitoring)

TITLE Power Board v4

The full source of this design is available at:
https://www.studentrobotics.org/git/boards/power-v4-hw.git

power-v4-hw.git/power-1-title.sch

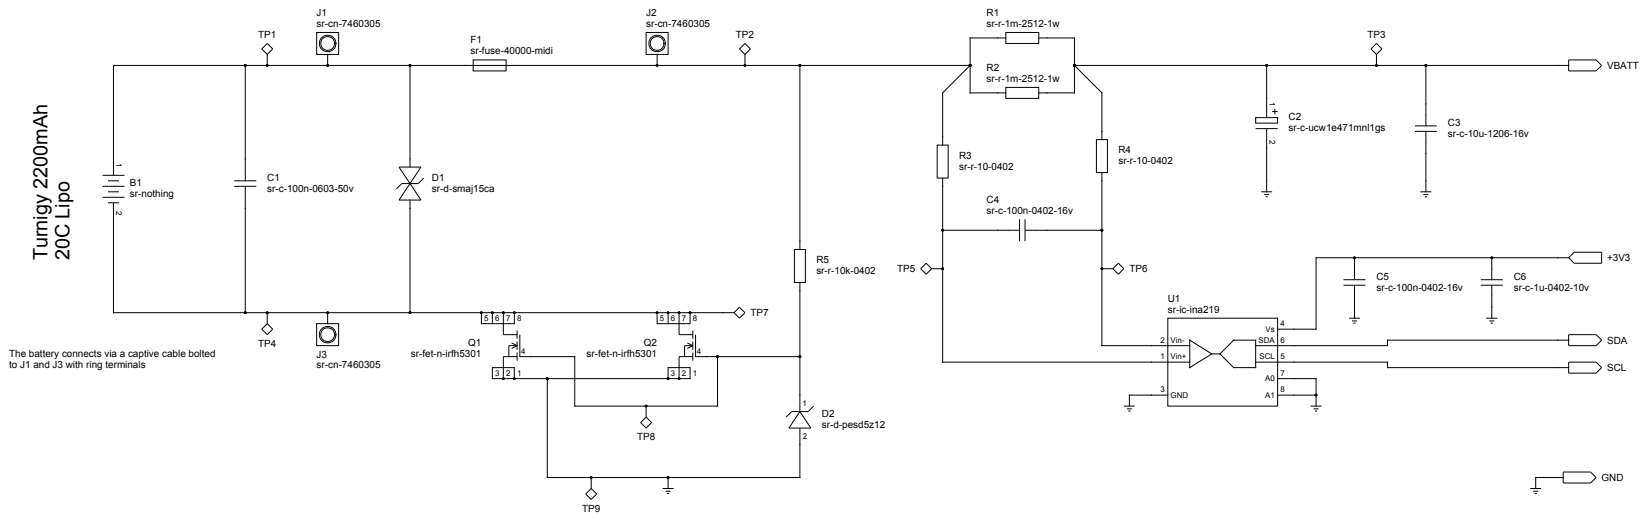
[picture p5: page 2]

The battery connects via a captive cable bolted
to J1 and J3 with ring terminals

TITLE Power Board v4 - Battery

power-v4-hw.git/power-2-battery.sch

# External power switch

# Fan

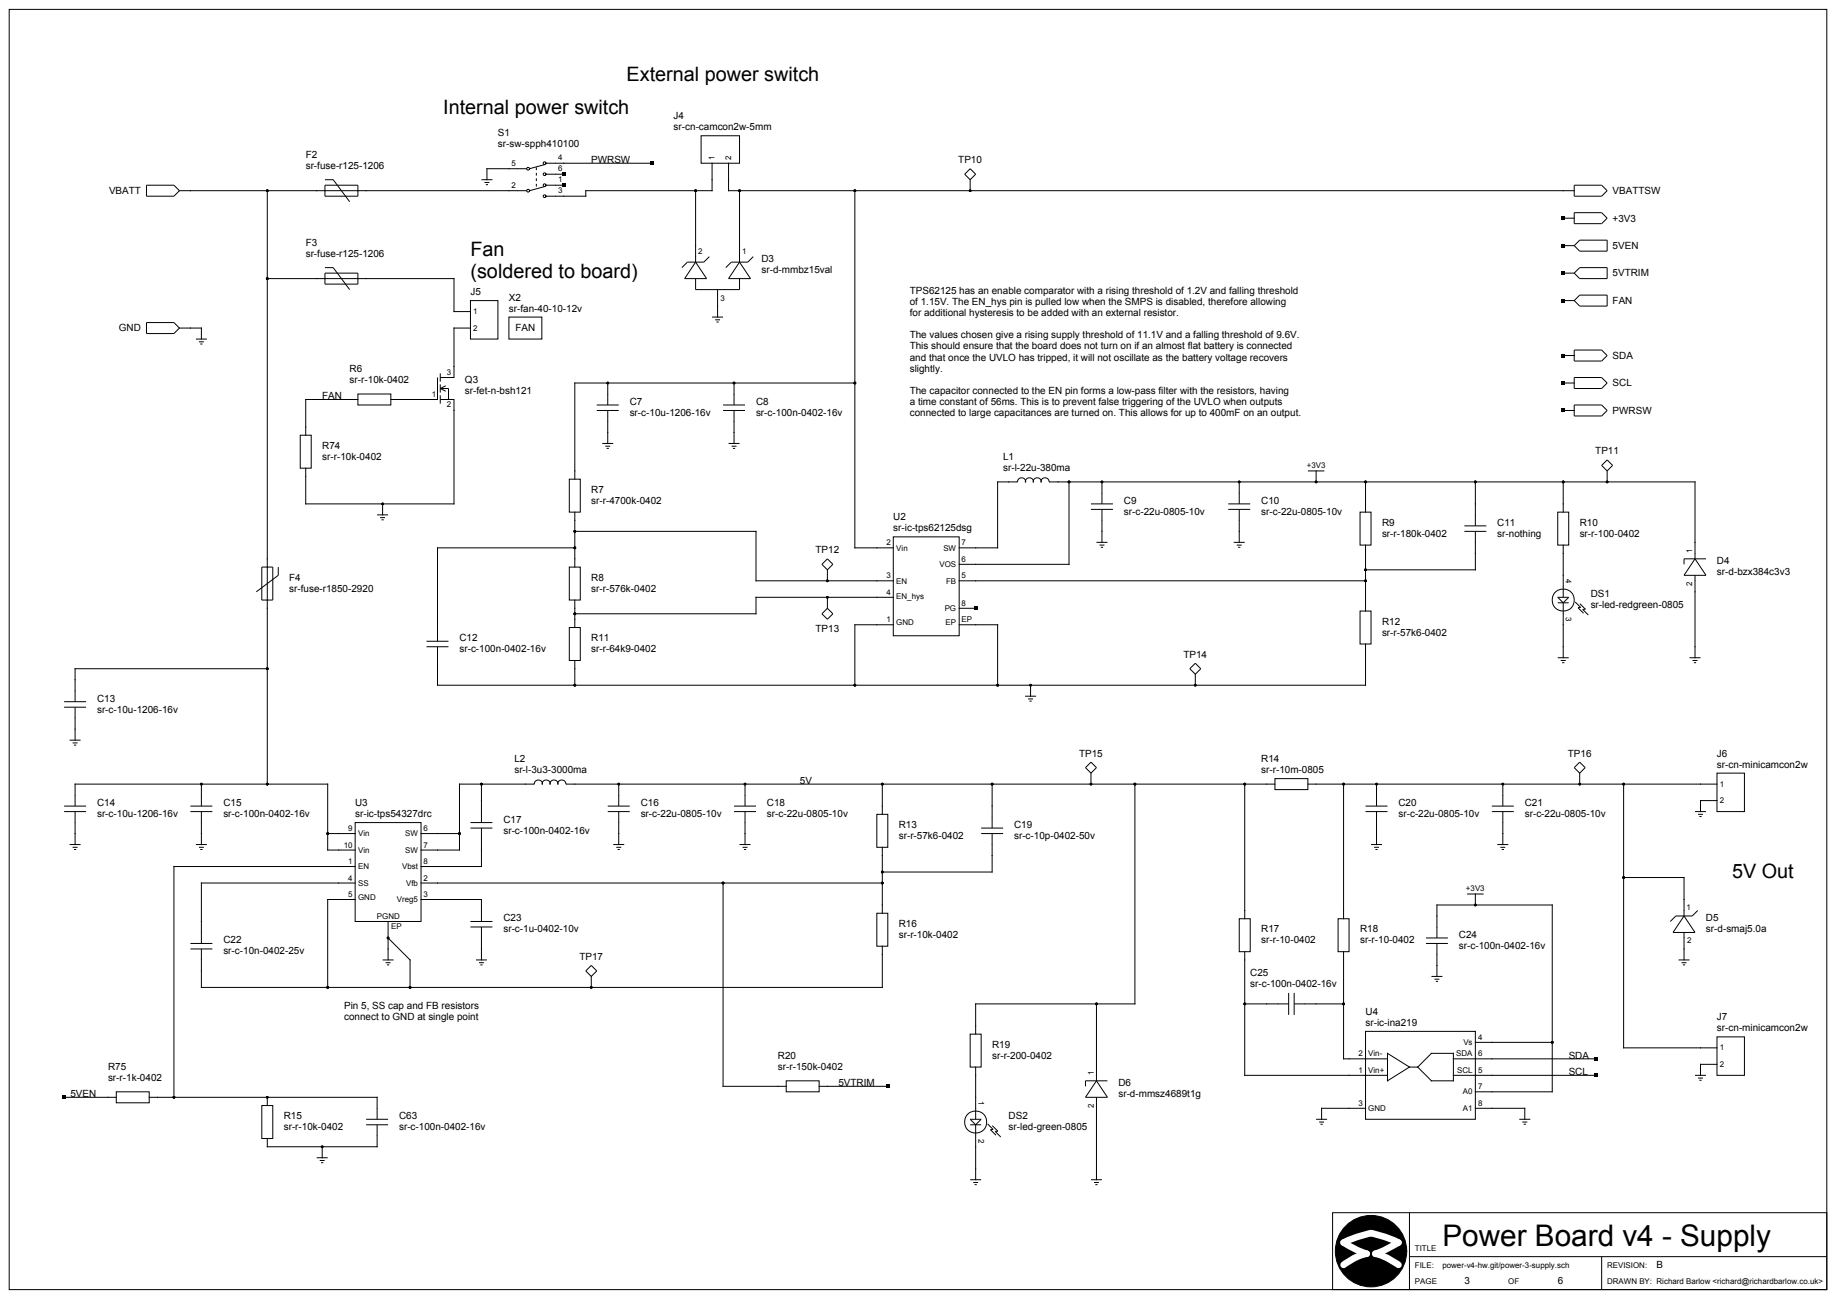
[picture p6: page 3]

TPS62125 has an enable comparator with a rising threshold of 1.2V and falling threshold
of 1.15V. The EN_hys pin is pulled low when the SMPS is disabled, therefore allowing
for additional hysteresis to be added with an external resistor.

The values chosen give a rising supply threshold of 11.1V and a falling threshold of 9.6V.
This should ensure that the board does not turn on if an almost flat battery is connected
and that once the UVLO has tripped, it will not oscillate as the battery voltage recovers
slightly.

The capacitor connected to the EN pin forms a low-pass filter with the resistors, having
a time constant of 56ms. This is to prevent false triggering of the UVLO when outputs
connected to large capacitances are turned on. This allows for up to 400mF on an output.

Pin 5, SS cap and FB resistors
connect to GND at single point

TITLE Power Board v4 - Supply

power-v4-hw.git/power-3-supply.sch

# High Power 0

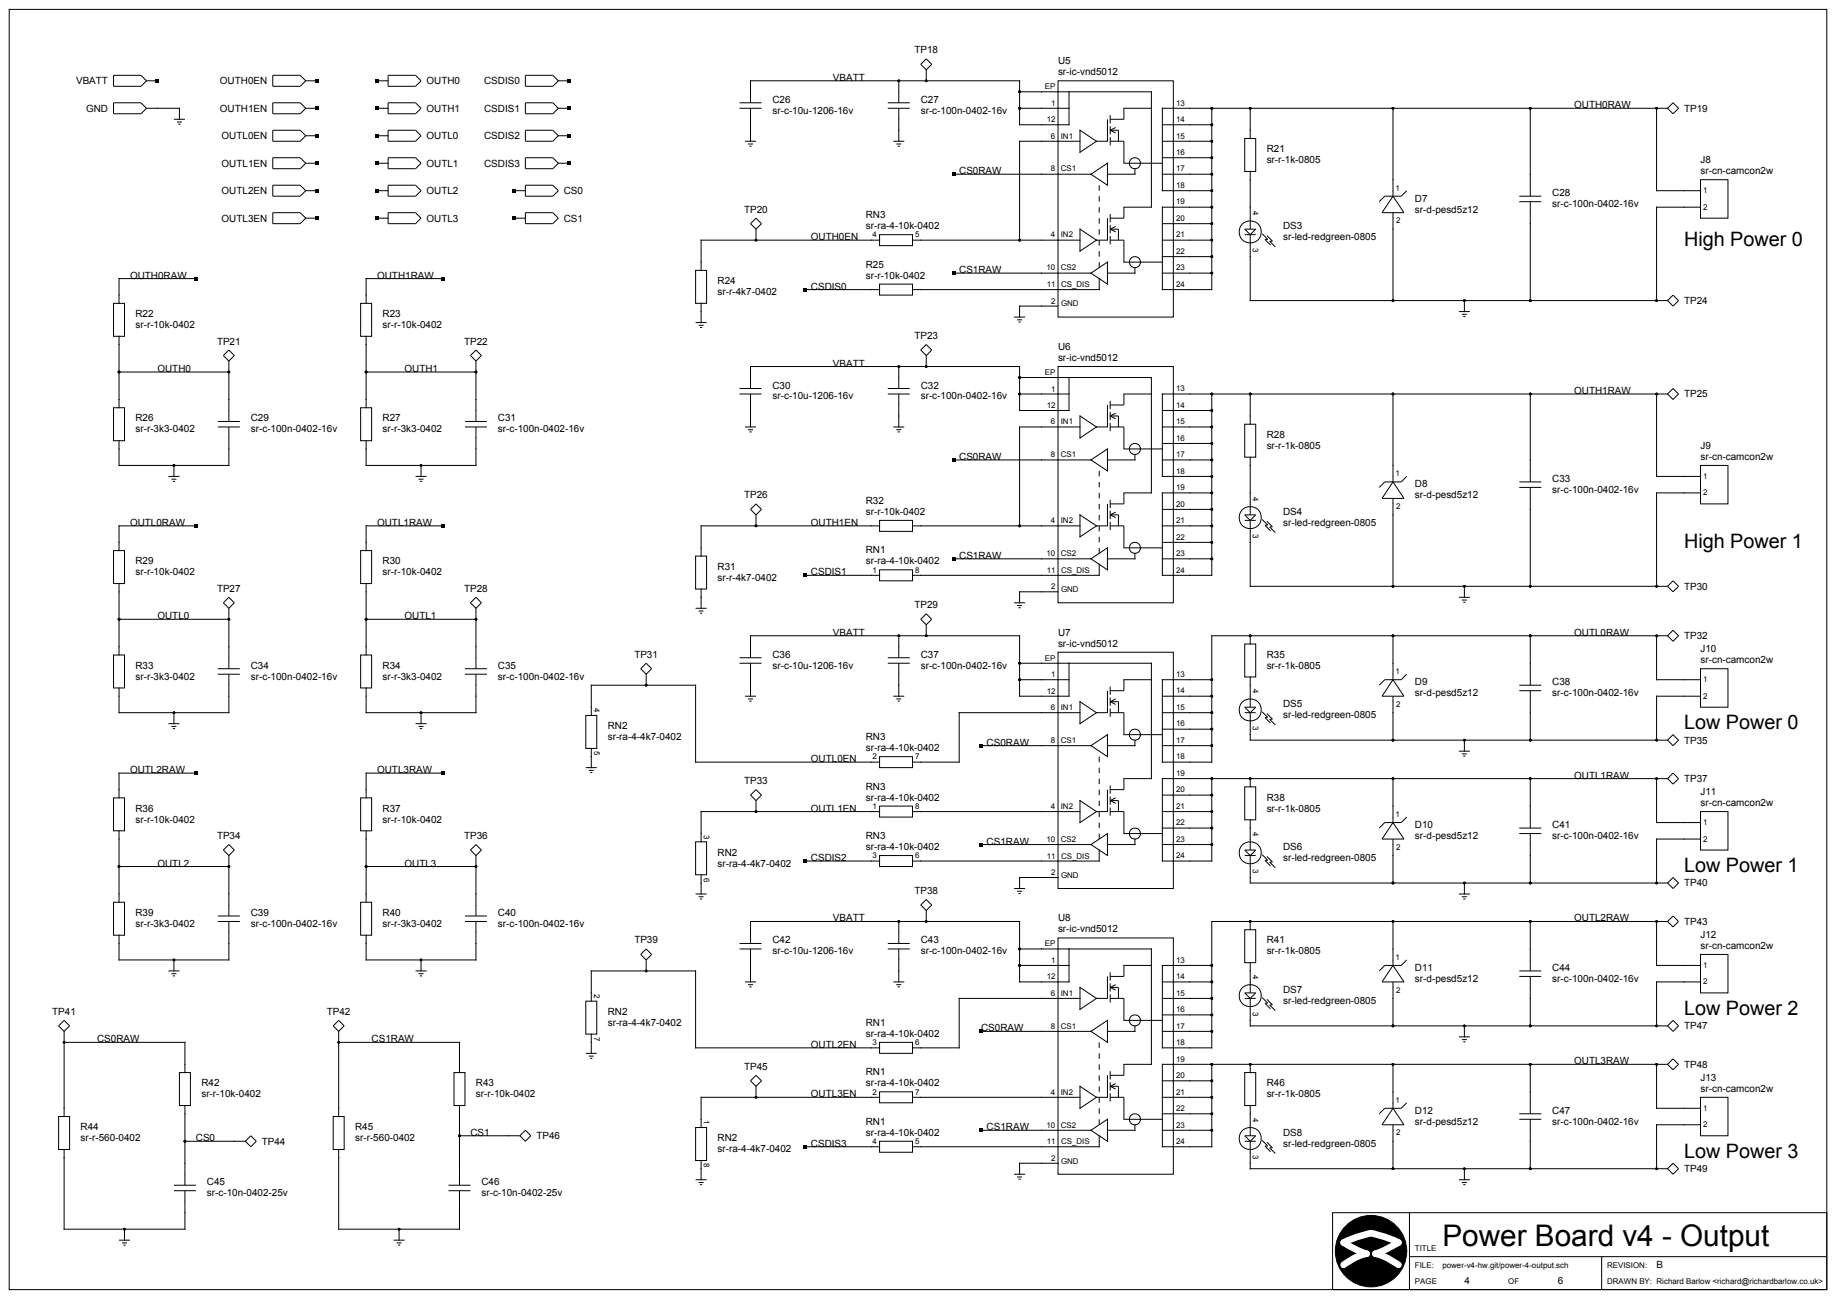
[picture p7: page 4]

TITLE Power Board v4 - Output

power-v4-hw.git/power-4-output.sch

# Internal Start Button

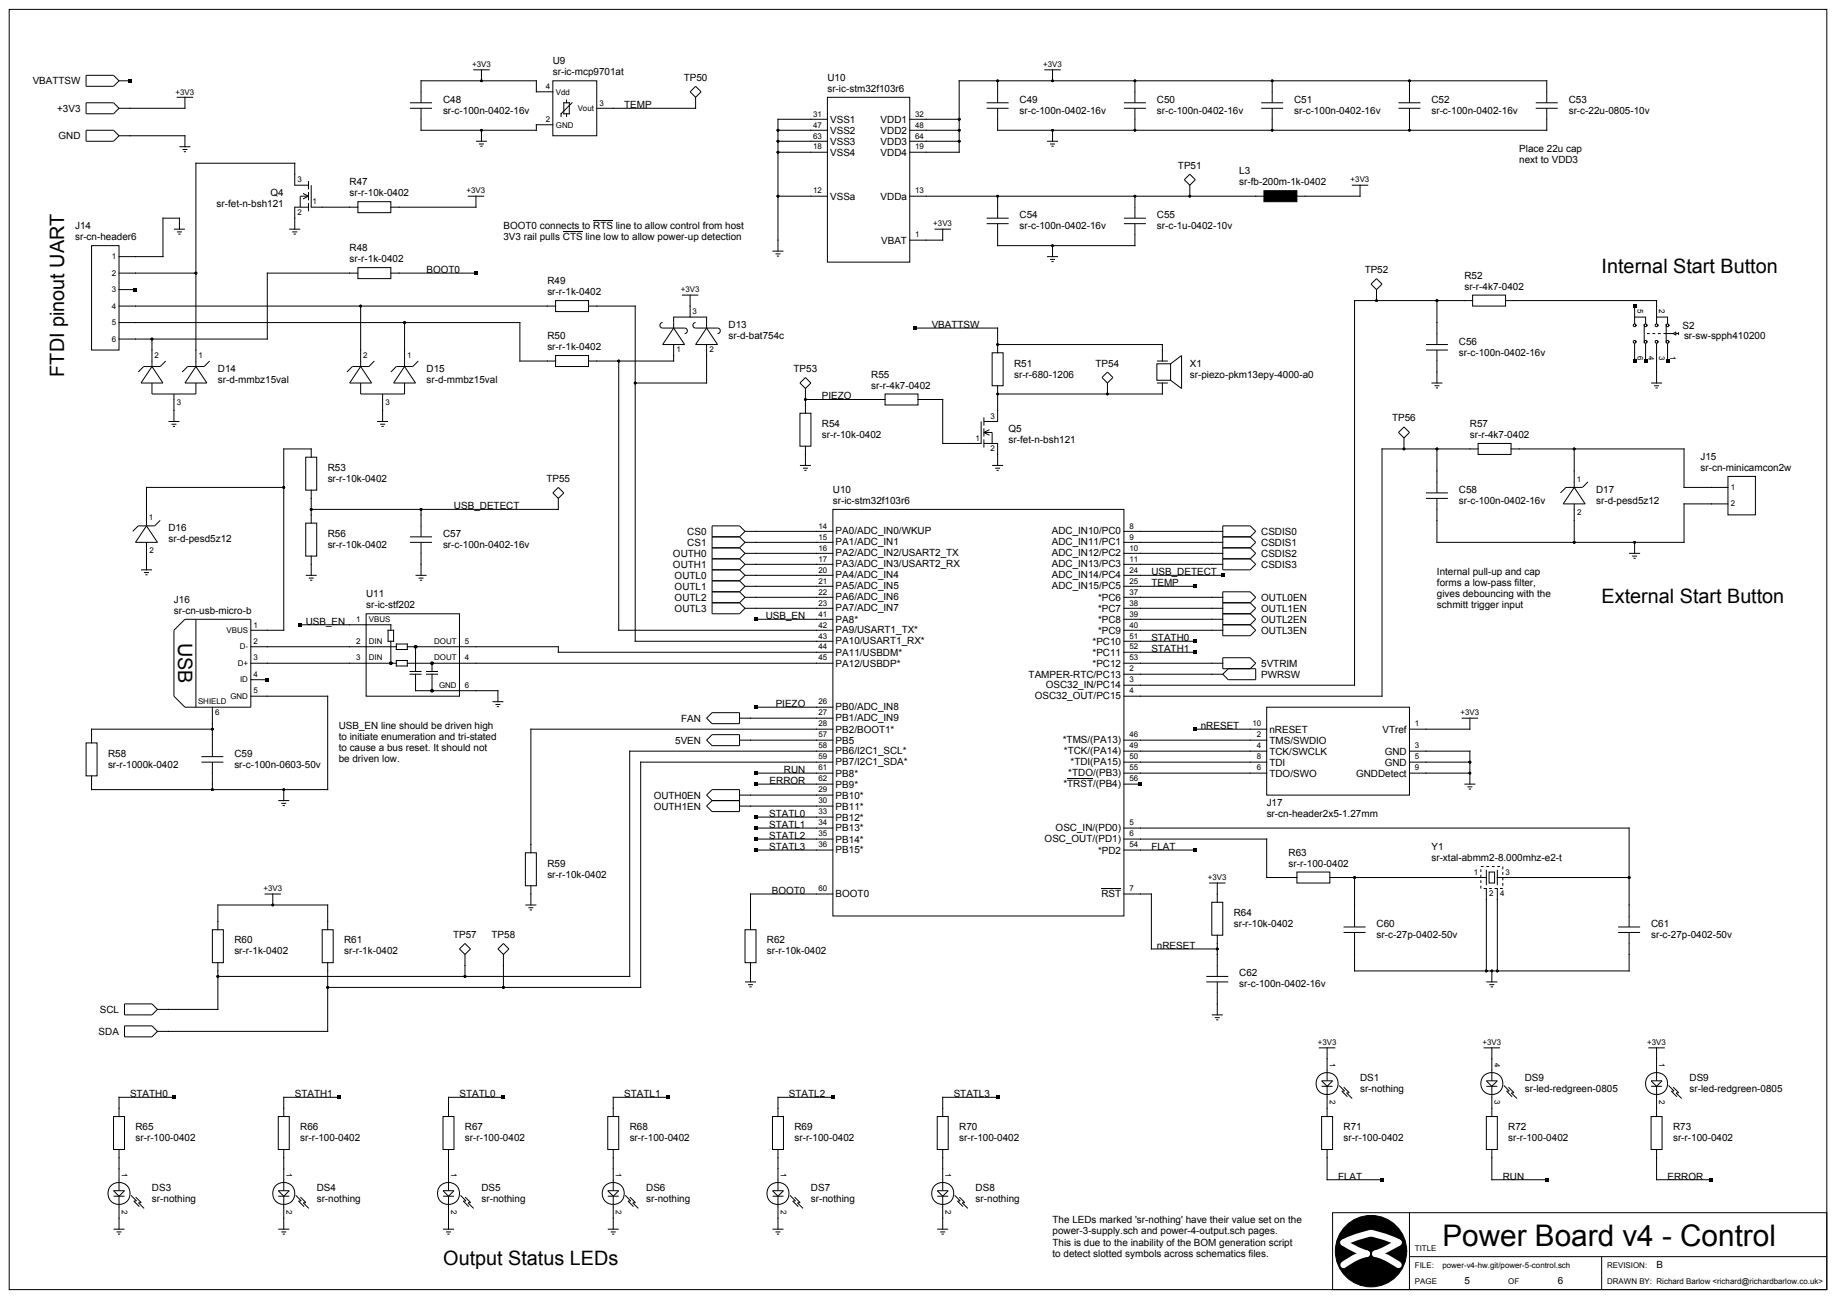
[picture p8: page 5]

BOOT0 connects to RTS line to allow control from host
3V3 rail pulls CTS line low to allow power-up detection

forms a low-pass filter,
gives debouncing with the
schmitt trigger input

USB J16
sr-cn-usb-micro-b

USB_EN line should be driven high
to initiate enumeration and tri-stated
to cause a bus reset. It should not
be driven low.

FLAT
TITLE Power Board v4 - Control

The LEDs marked 'sr-nothing' have their value set on the
power-3-supply.sch and power-4-output.sch pages.
This is due to the inability of the BOM generation script
to detect slotted symbols across schematics files.

power-v4-hw.git/power-5-control.sch

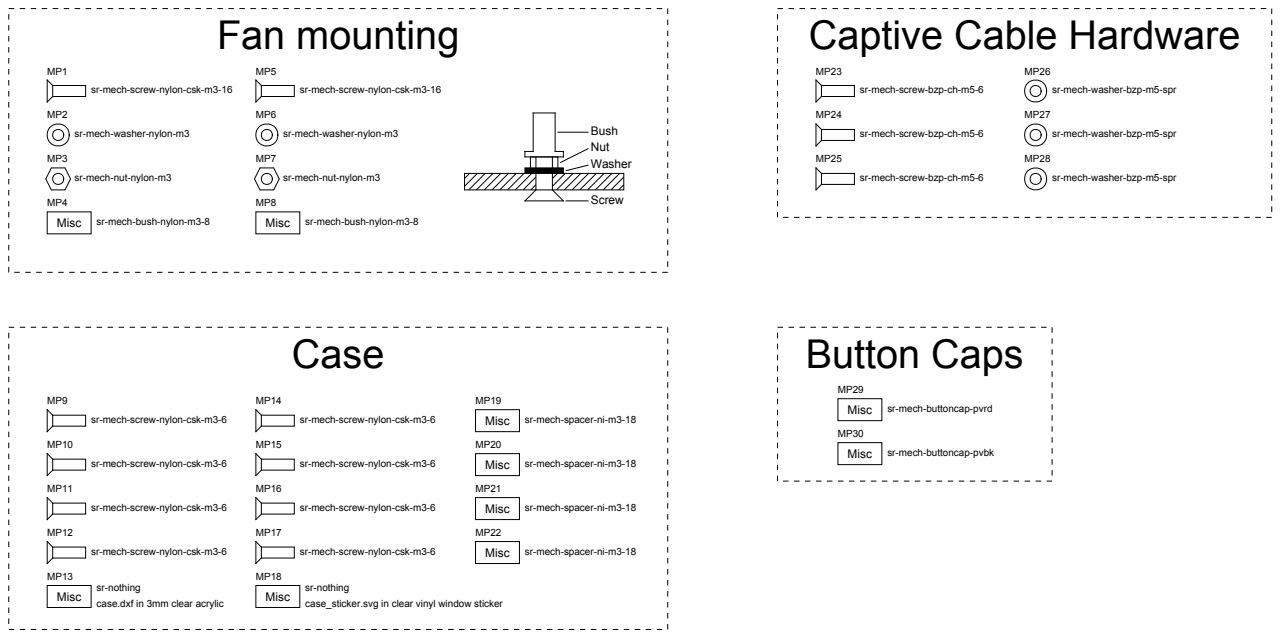
[picture p9: page 6]
Misc; Fan mounting; Screw; Washer; Nut; Bush; Case MP9; Button Caps; sr-nothing; case.dxf in 3mm clear acrylic

Captive Cable Hardware

sr-mech-washer-bzp-m5-spr

sr-mech-screw-nylon-csk-m3-16

sr-mech-screw-bzp-ch-m5-6

sr-mech-washer-nylon-m3

sr-mech-nut-nylon-m3

sr-mech-bush-nylon-m3-8

sr-mech-buttoncap-pvrd

sr-mech-screw-nylon-csk-m3-6

sr-mech-spacer-ni-m3-18

sr-mech-buttoncap-pvbk

sr-nothing
case_sticker.svg in clear vinyl window sticker

TITLE Power Board v4 - Mechanical

power-v4-hw.git/power-6-mechanical.sch
