sourcebots/kit-manufacture-2019/quote-pack/servo/servo-schematic.pdf

12V

# Aux

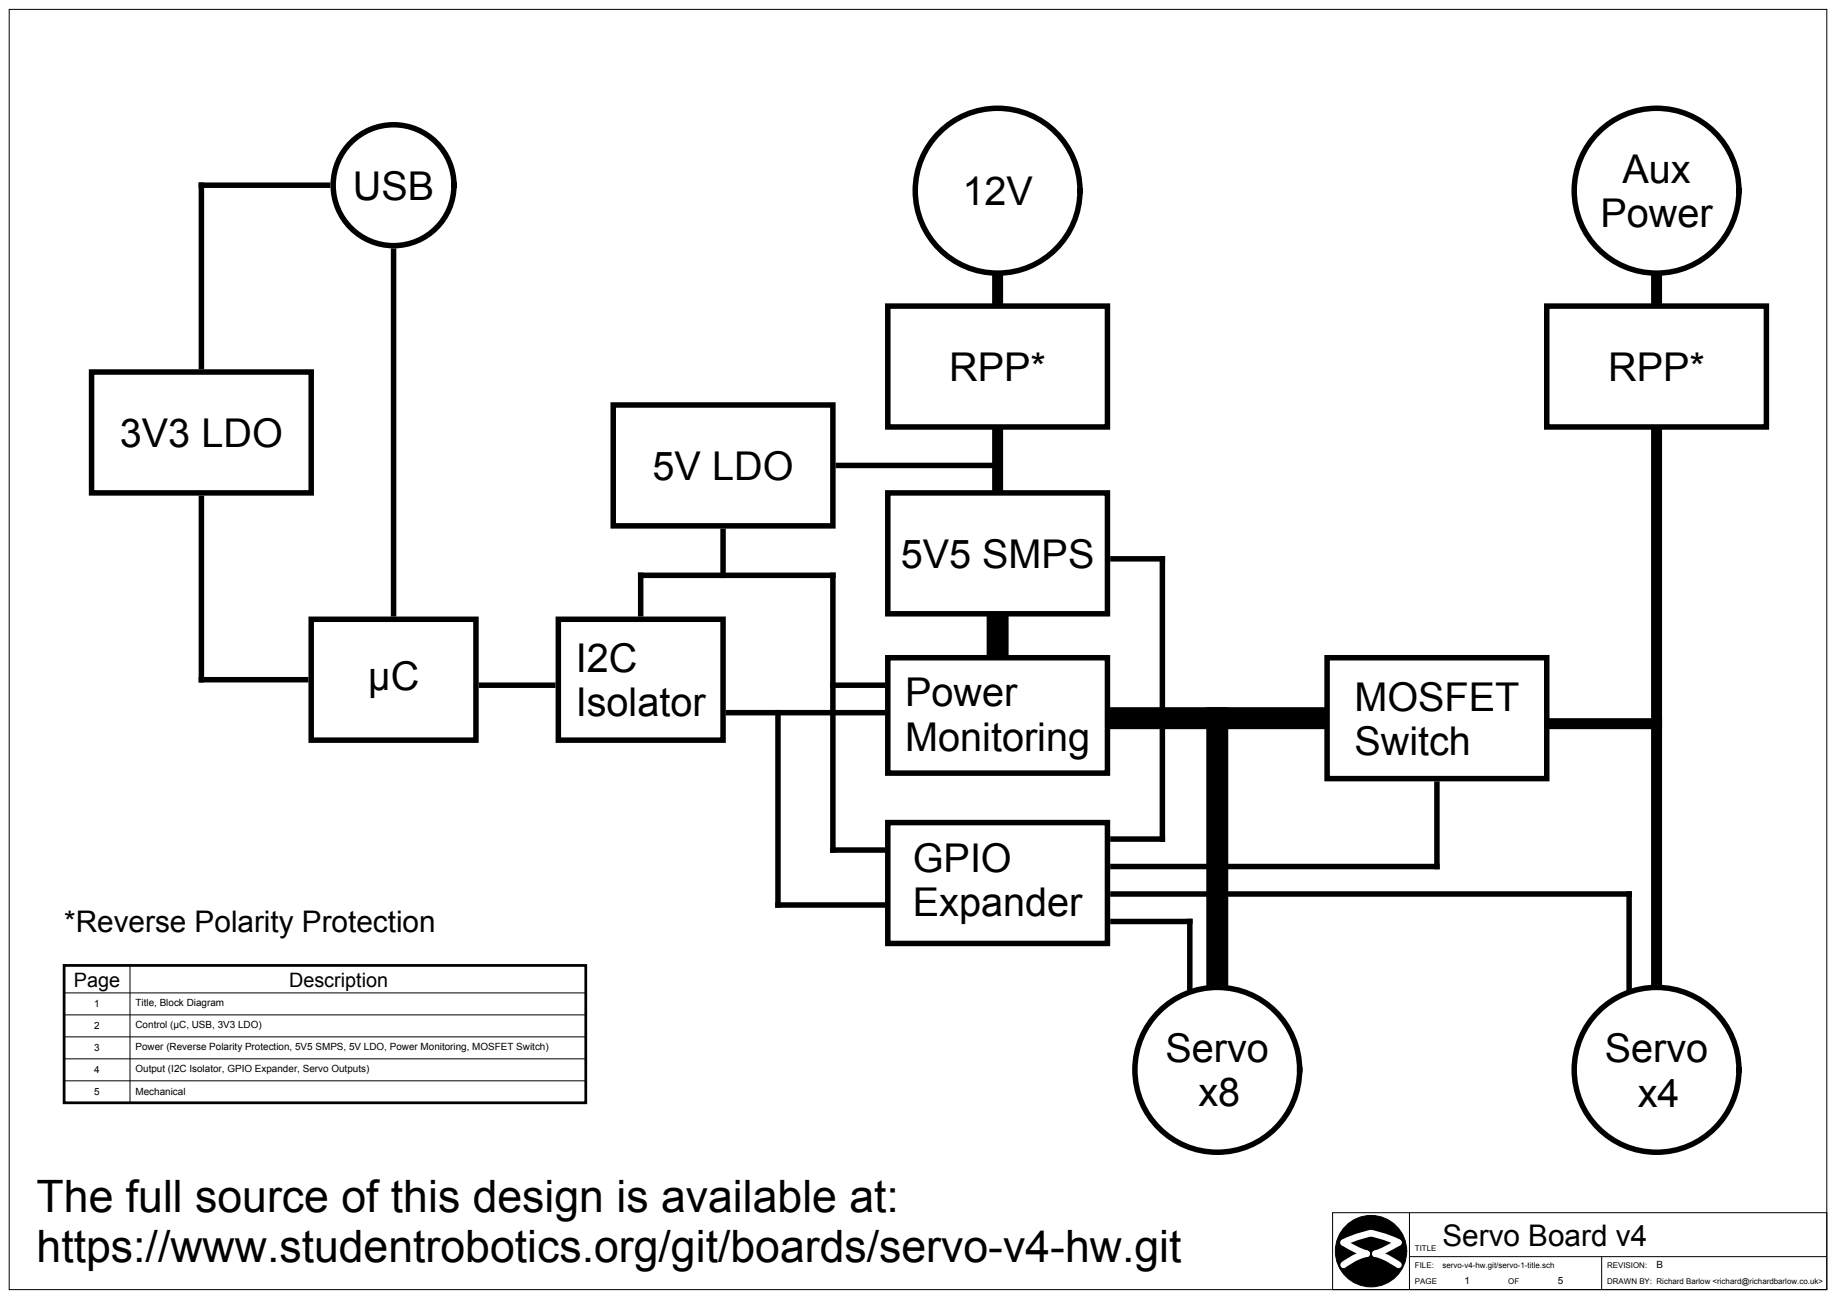
[picture p10: page 1]
FILE:; REVISION:; PAGE; DRAWN BY:; Richard Barlow <richard@richardbarlow.co.uk>; Page; Description; https://www.studentrobotics.org/git/boards/servo-v4-hw.git; Mechanical; Power; MOSFET Switch; Power Monitoring; GPIO Expander; USB; I2C Isolator; 3V3 LDO; 5V5 SMPS; Servo x8; Servo x4; 5V LDO; RPP*

*Reverse Polarity Protection

Title, Block Diagram

Control (µC, USB, 3V3 LDO)

Power (Reverse Polarity Protection, 5V5 SMPS, 5V LDO, Power Monitoring, MOSFET Switch)

Output (I2C Isolator, GPIO Expander, Servo Outputs)

The full source of this design is available at:

TITLE Servo Board v4

servo-v4-hw.git/servo-1-title.sch

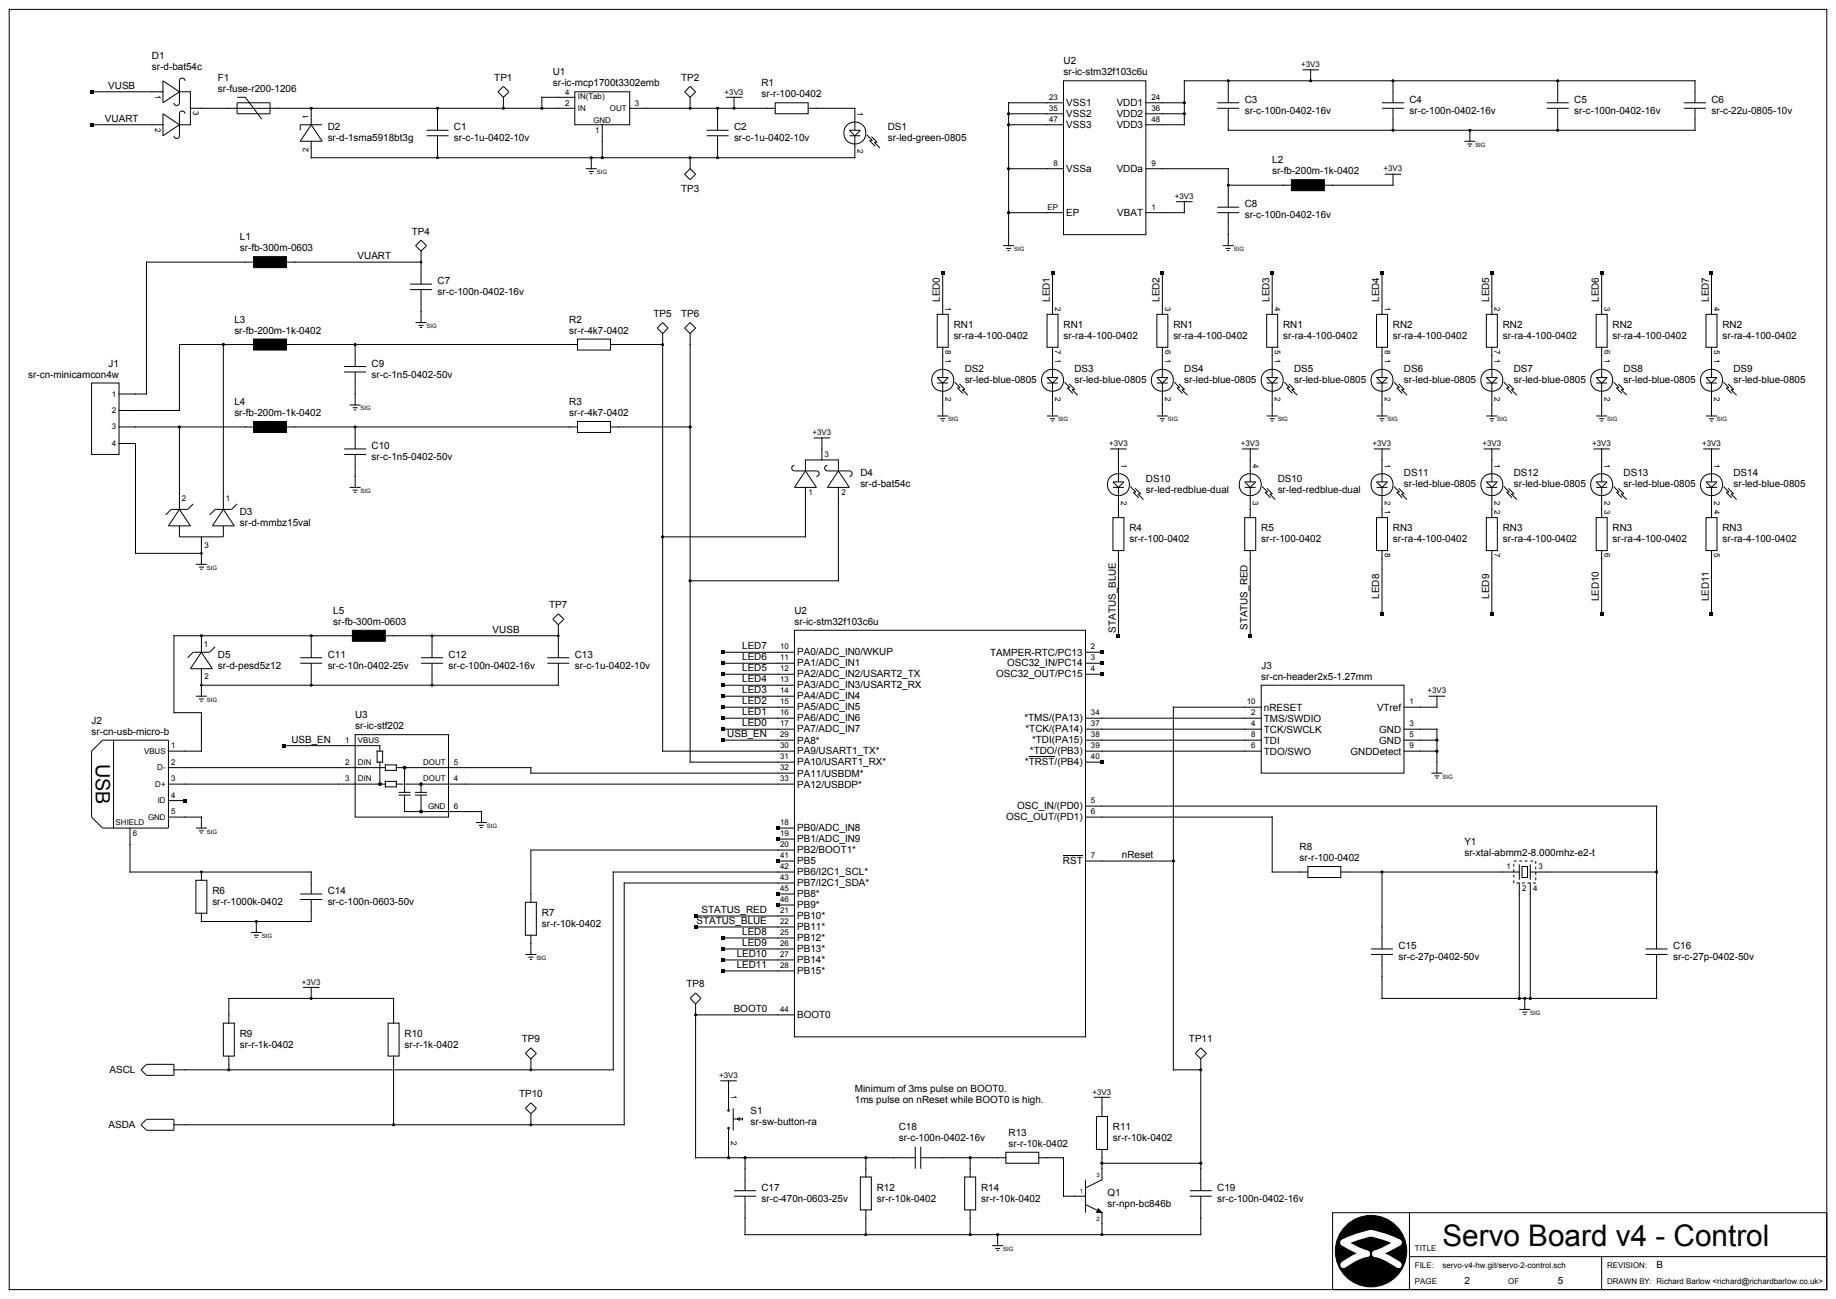
[picture p11: page 2]

USB J2
sr-cn-usb-micro-b

Minimum of 3ms pulse on BOOT0.
1ms pulse on nReset while BOOT0 is high.

TITLE Servo Board v4 - Control

servo-v4-hw.git/servo-2-control.sch

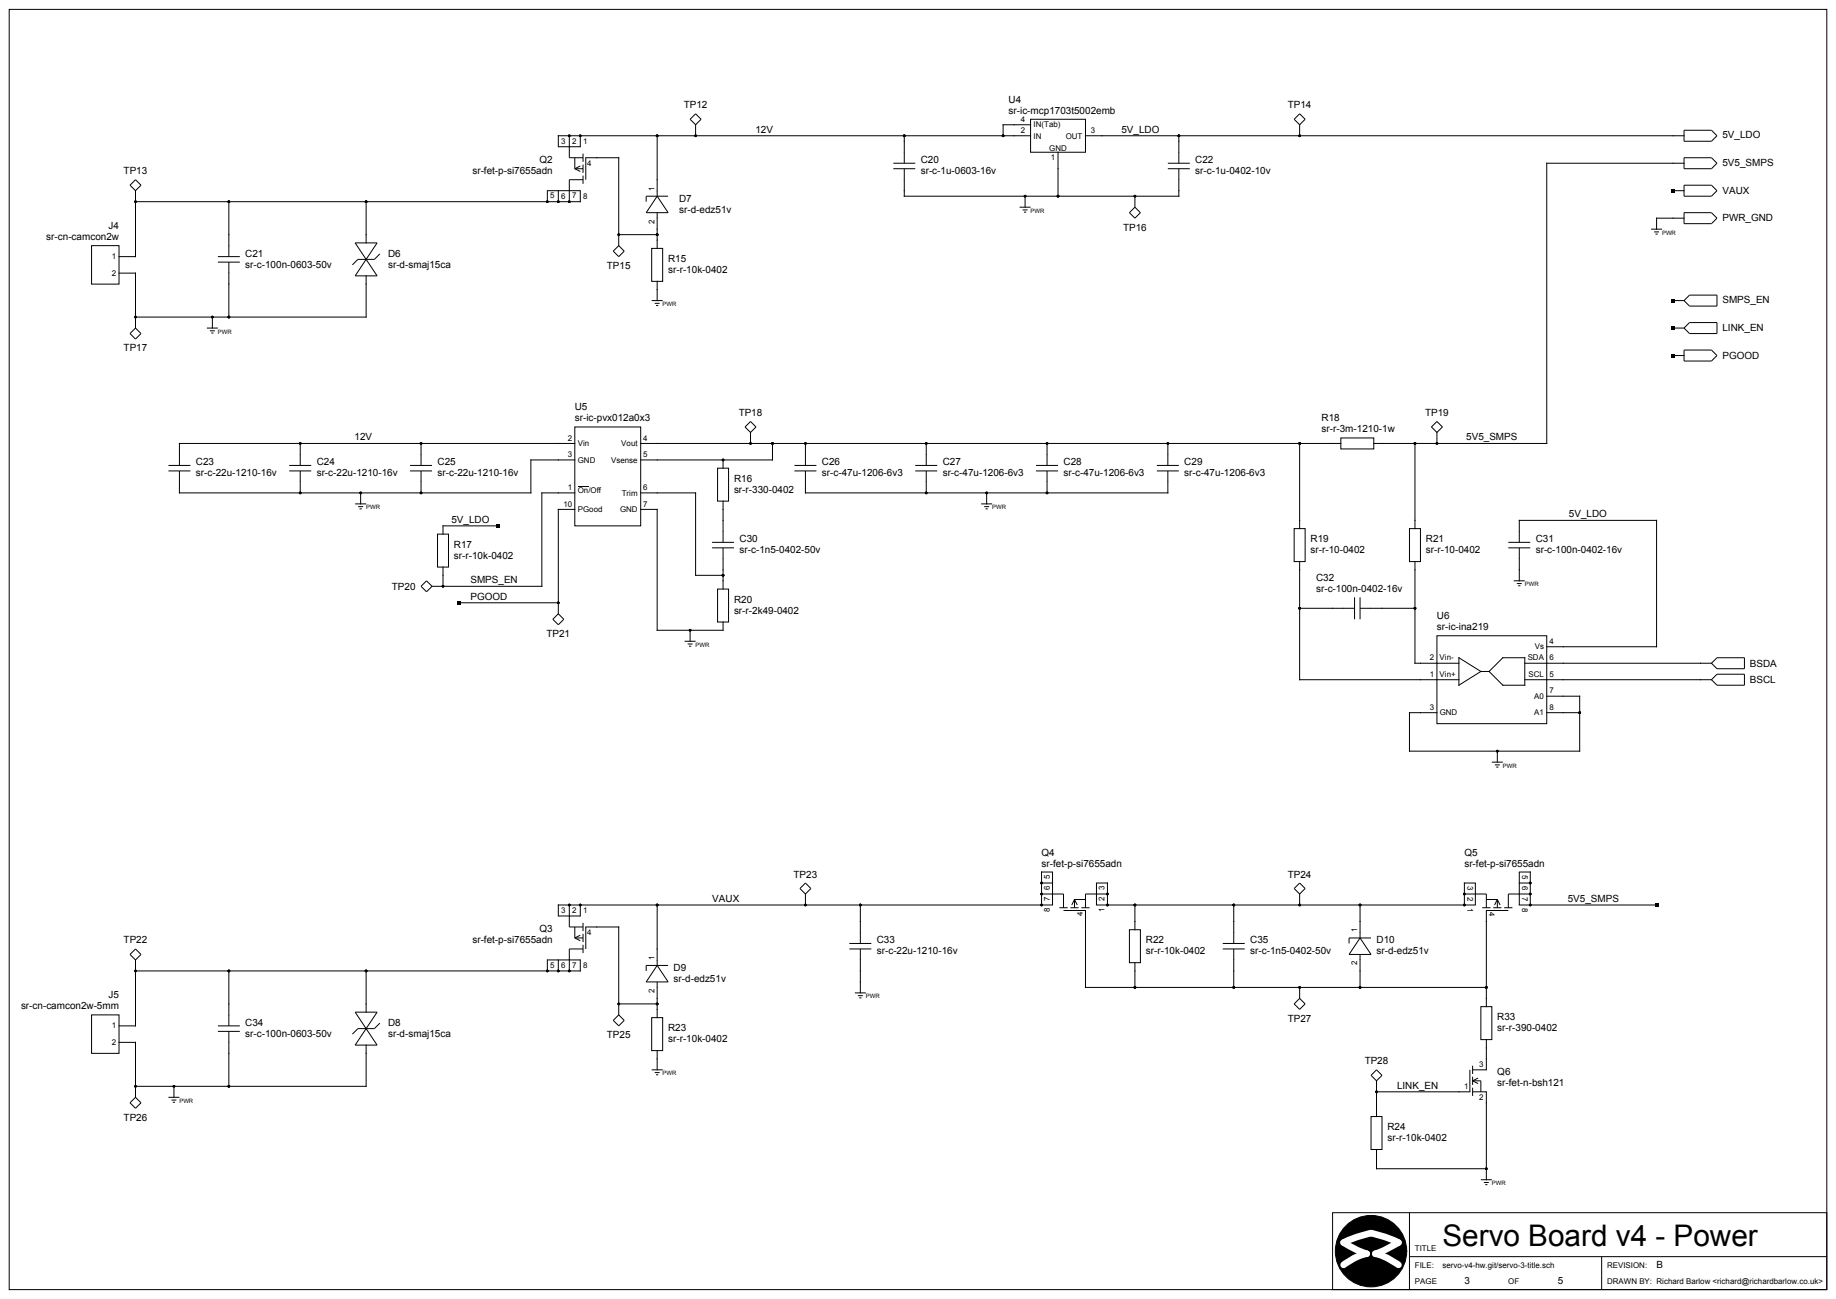
[picture p12: page 3]

PWR
TITLE Servo Board v4 - Power

servo-v4-hw.git/servo-3-title.sch

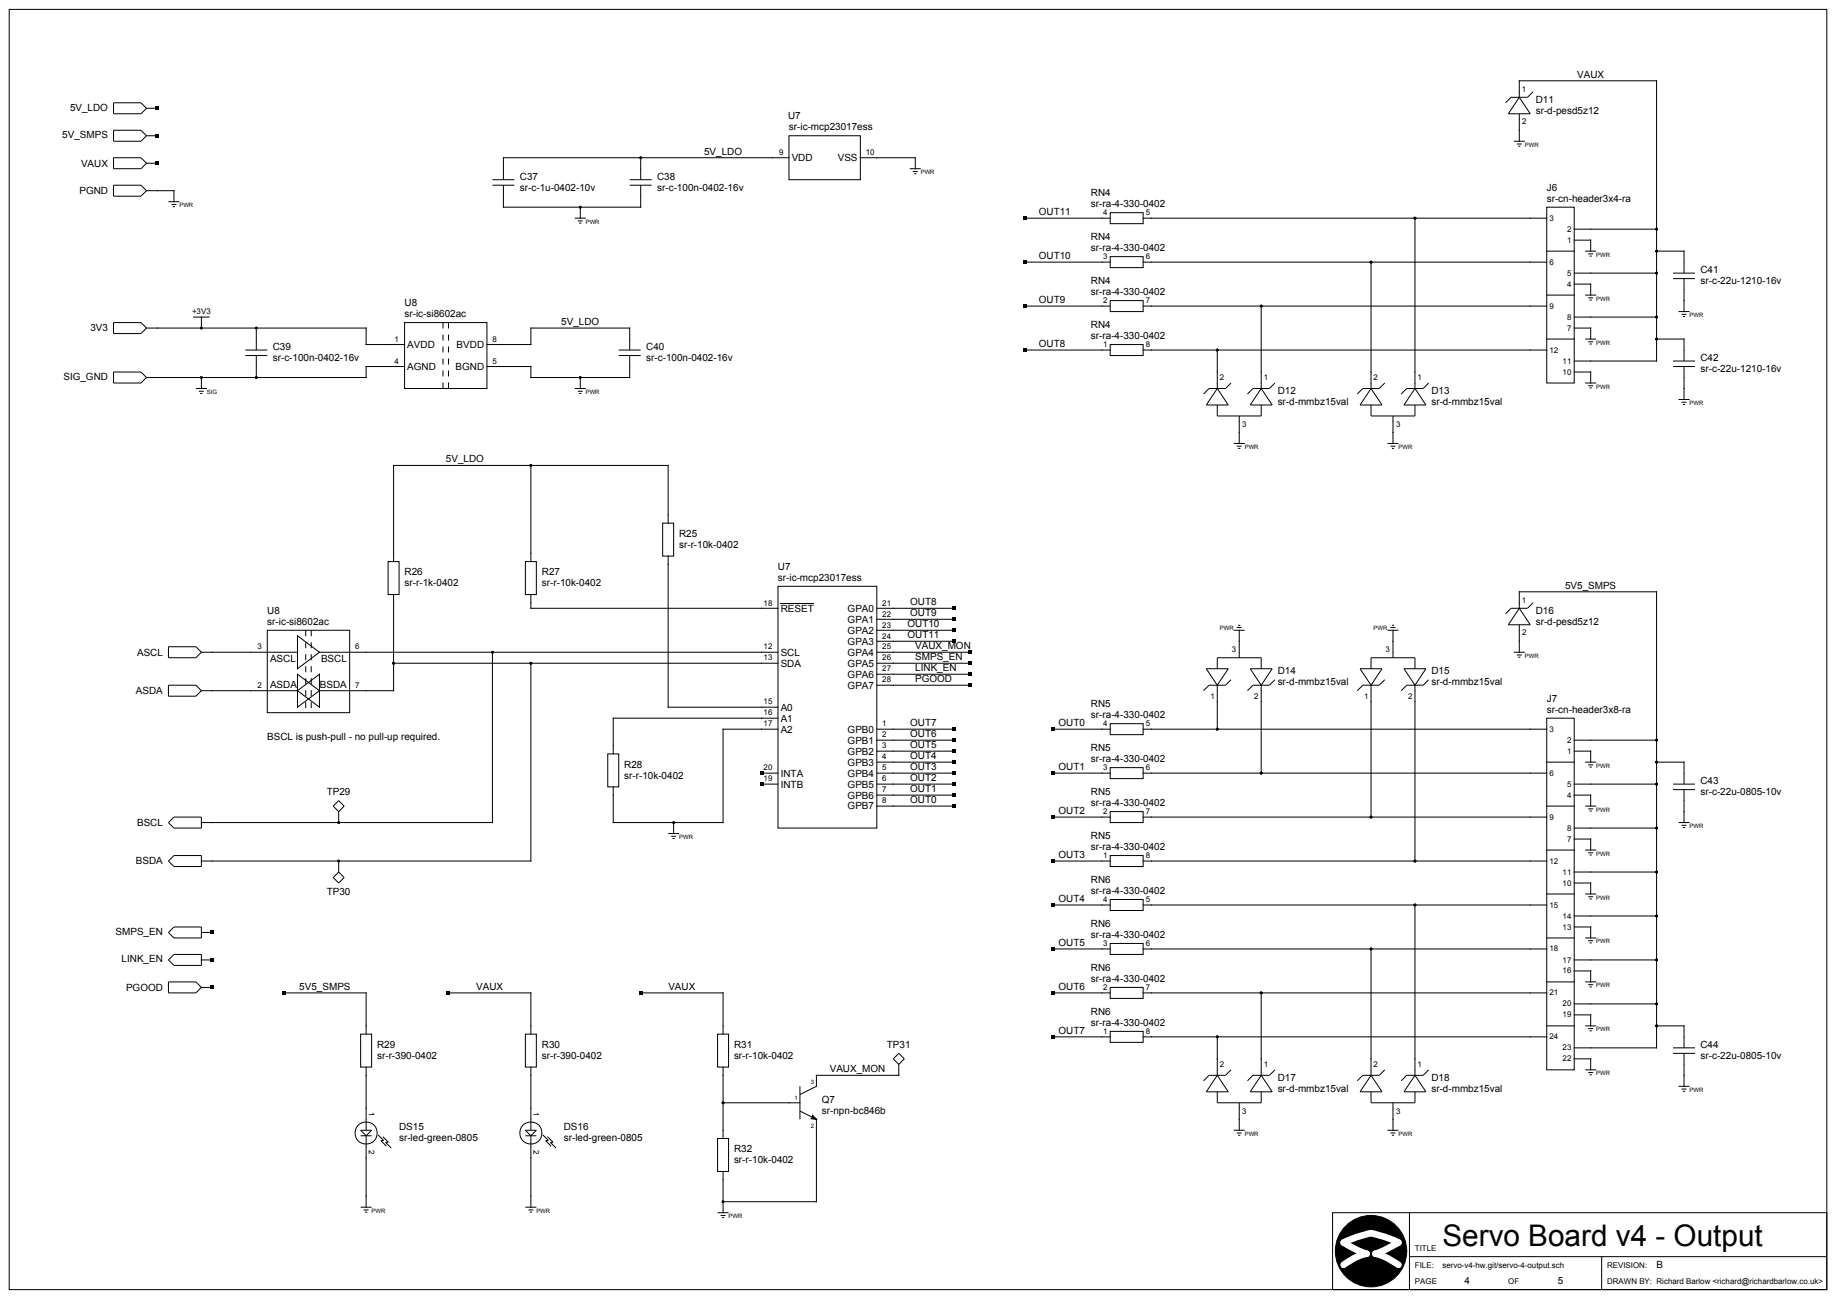
[picture p13: page 4]

BSCL is push-pull - no pull-up required.

INTB ¹⁹ INTA ²⁰

TITLE Servo Board v4 - Output

servo-v4-hw.git/servo-4-output.sch

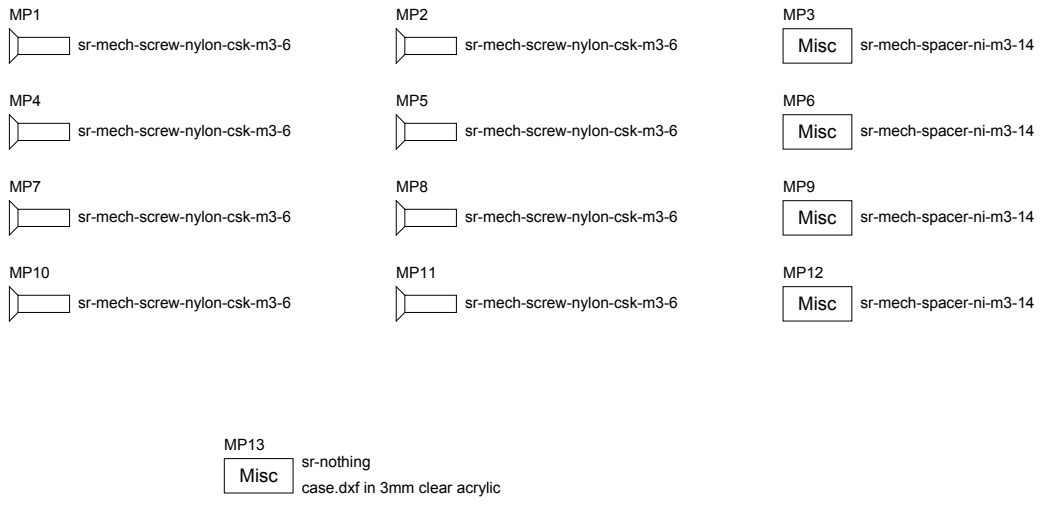
[picture p14: page 5]
Misc

sr-mech-screw-nylon-csk-m3-6

sr-mech-spacer-ni-m3-14

sr-nothing
case.dxf in 3mm clear acrylic

TITLE Servo Board v4 - Mechanical

servo-v4-hw.git/servo-5-mechanical.sch
