sourcebots/kit-manufacture-2019/quote-pack/motor/motor-polarities.pdf

# DS8 and DS9 can have

either orientation.

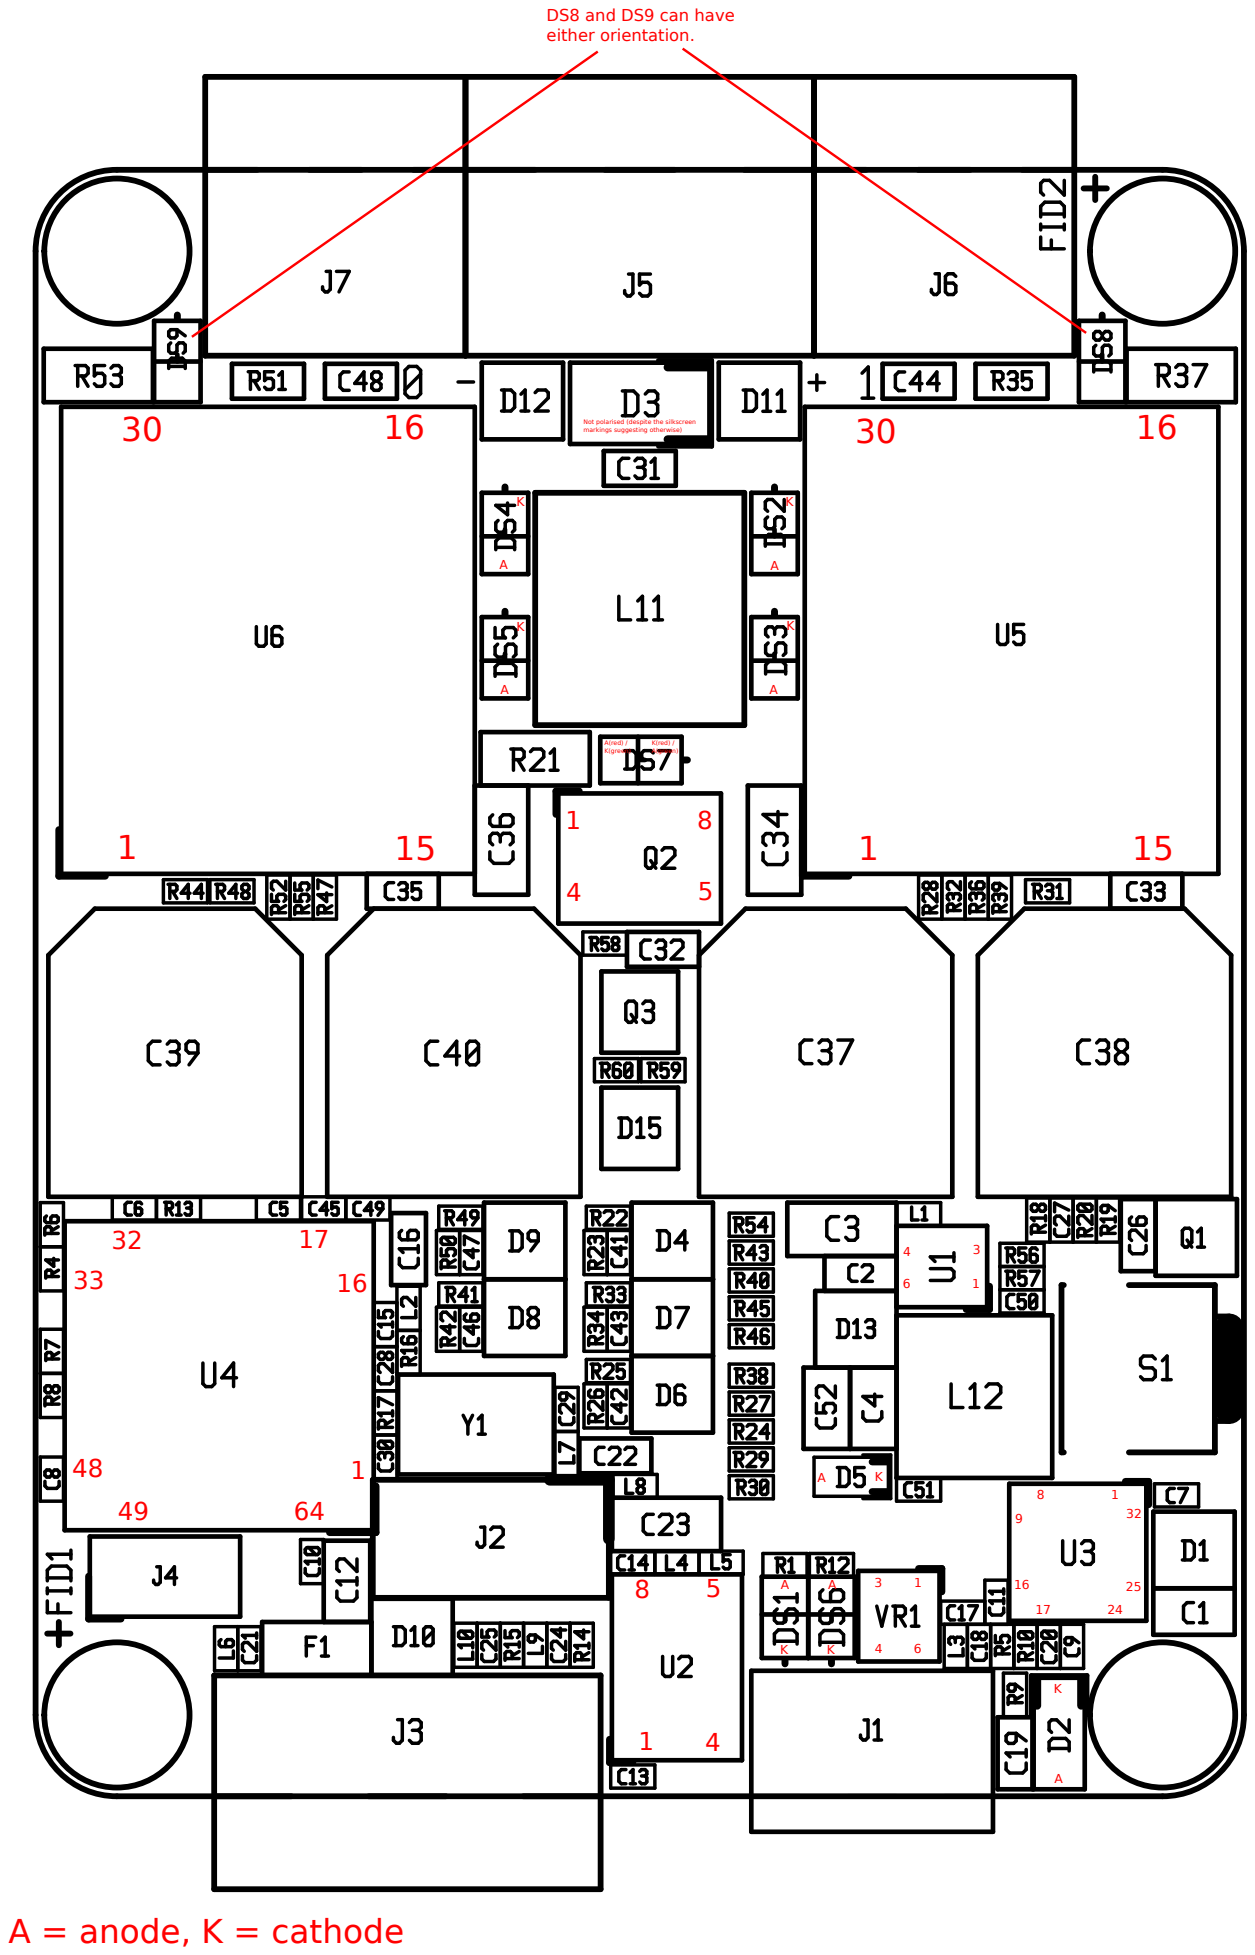
[picture p15: page 1]
A(red) / K(green); K(red) / A(green); A = anode, K = cathode

Not polarised (despite the silkscreen
markings suggesting otherwise)
