sourcebots/kit-manufacture-2019/quote-pack/power/power-polarities.pdf

A

K

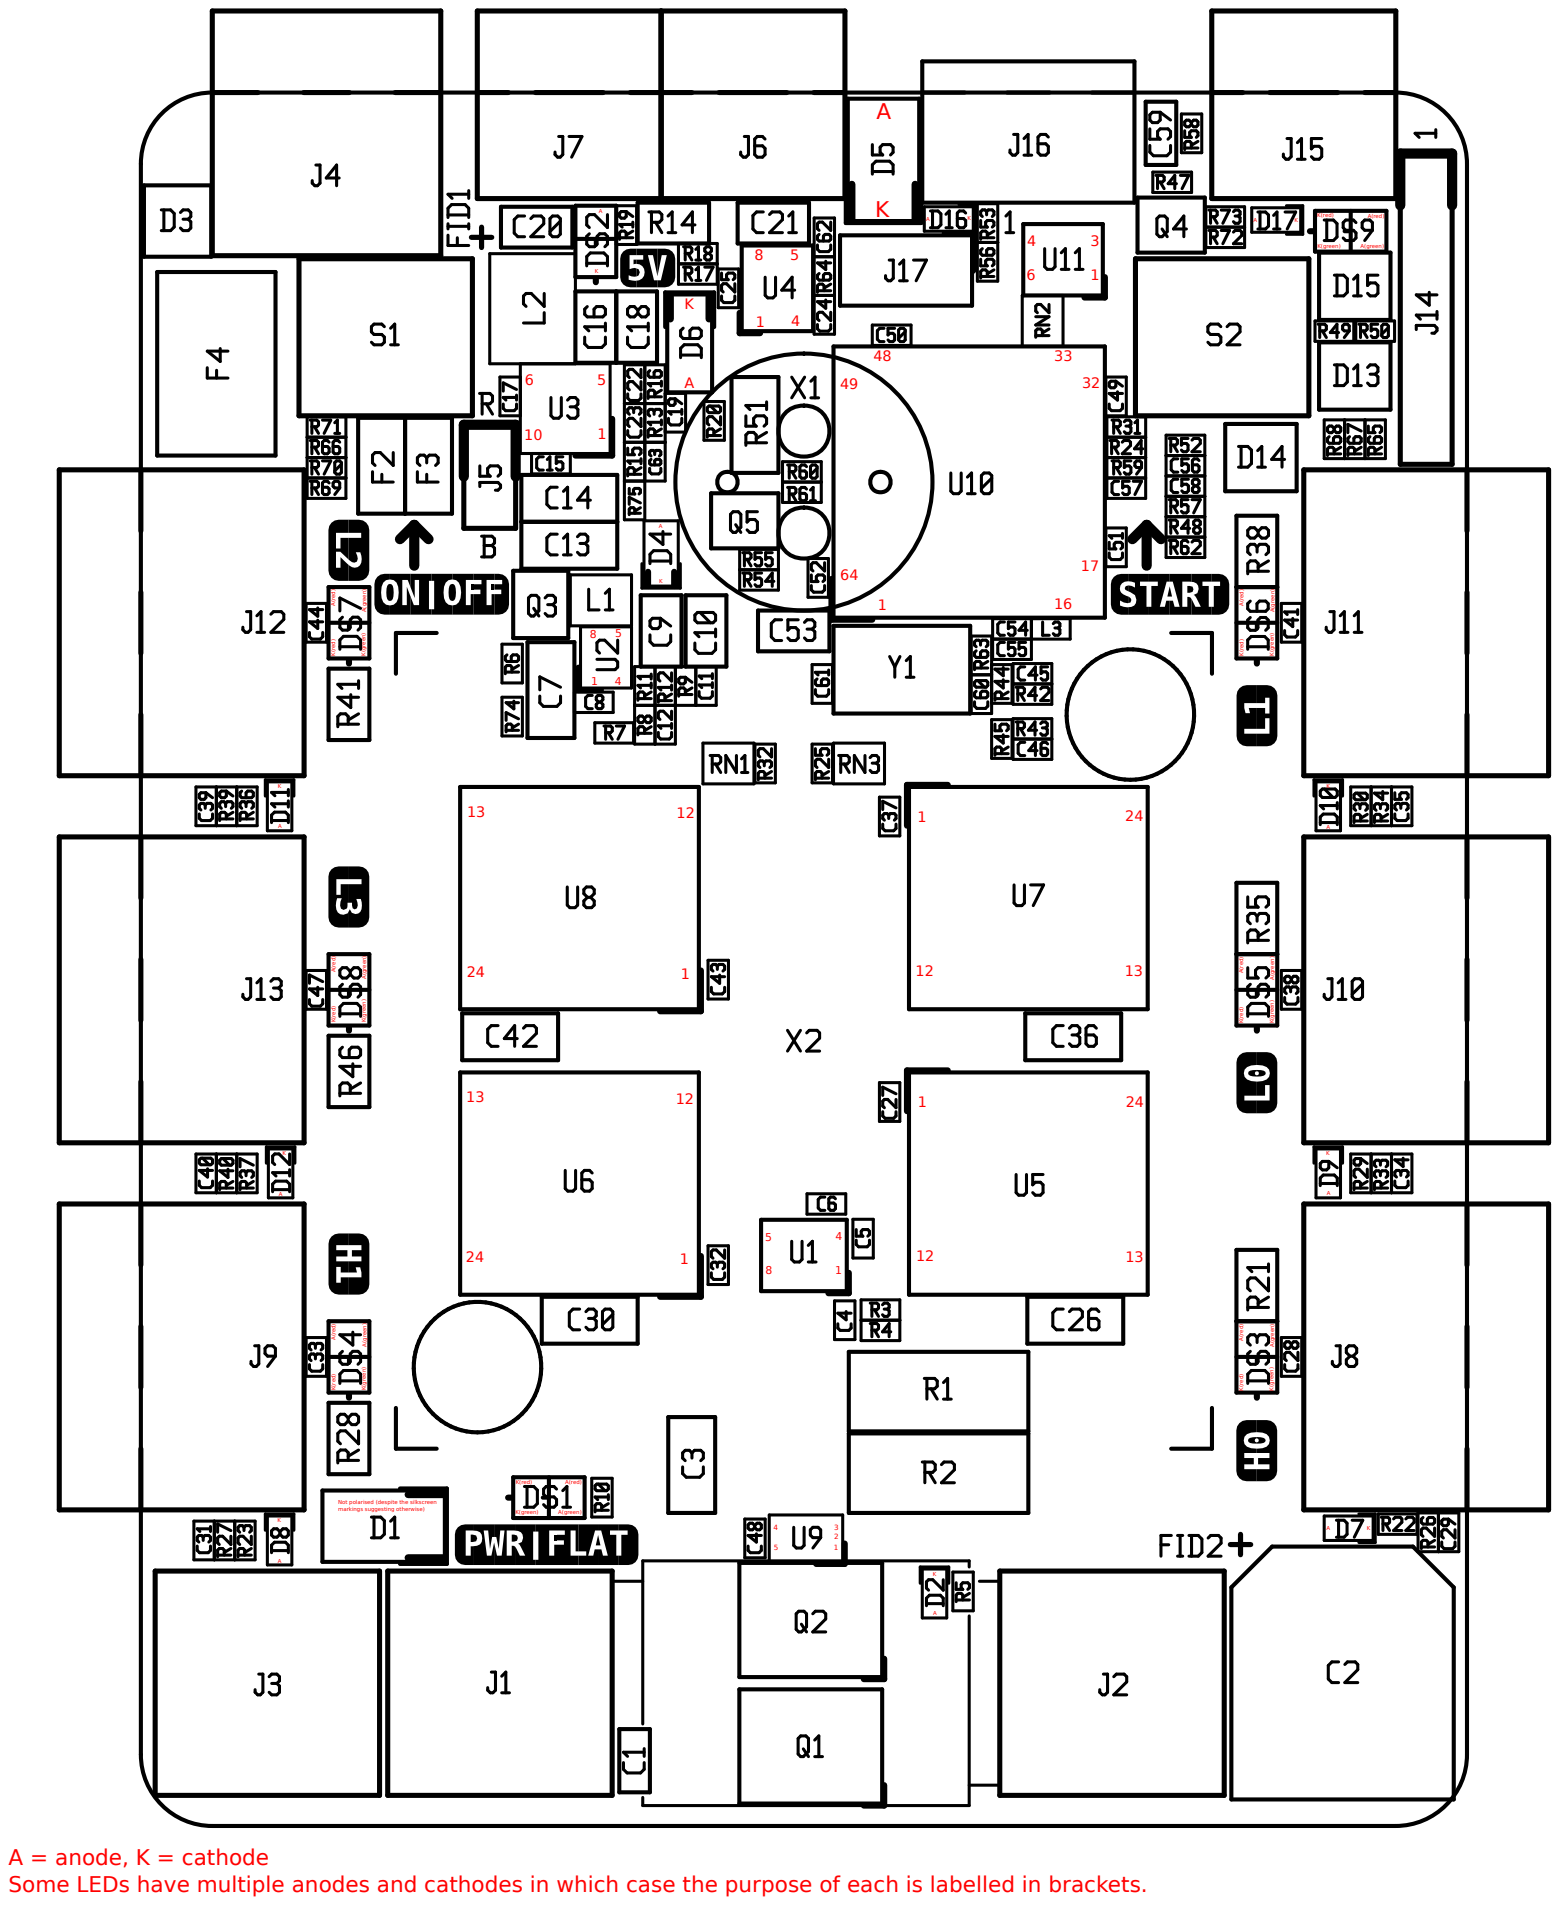
[picture p16: page 1]
K(red); A(red); K(green); A(green)

Not polarised (despite the silkscreen
markings suggesting otherwise)

A = anode, K = cathode
Some LEDs have multiple anodes and cathodes in which case the purpose of each is labelled in brackets.
