sourcebots/kit-manufacture-2019/quote-pack/servo/servo-polarities.pdf

8 5 1 4 | | | 8 5 1 4

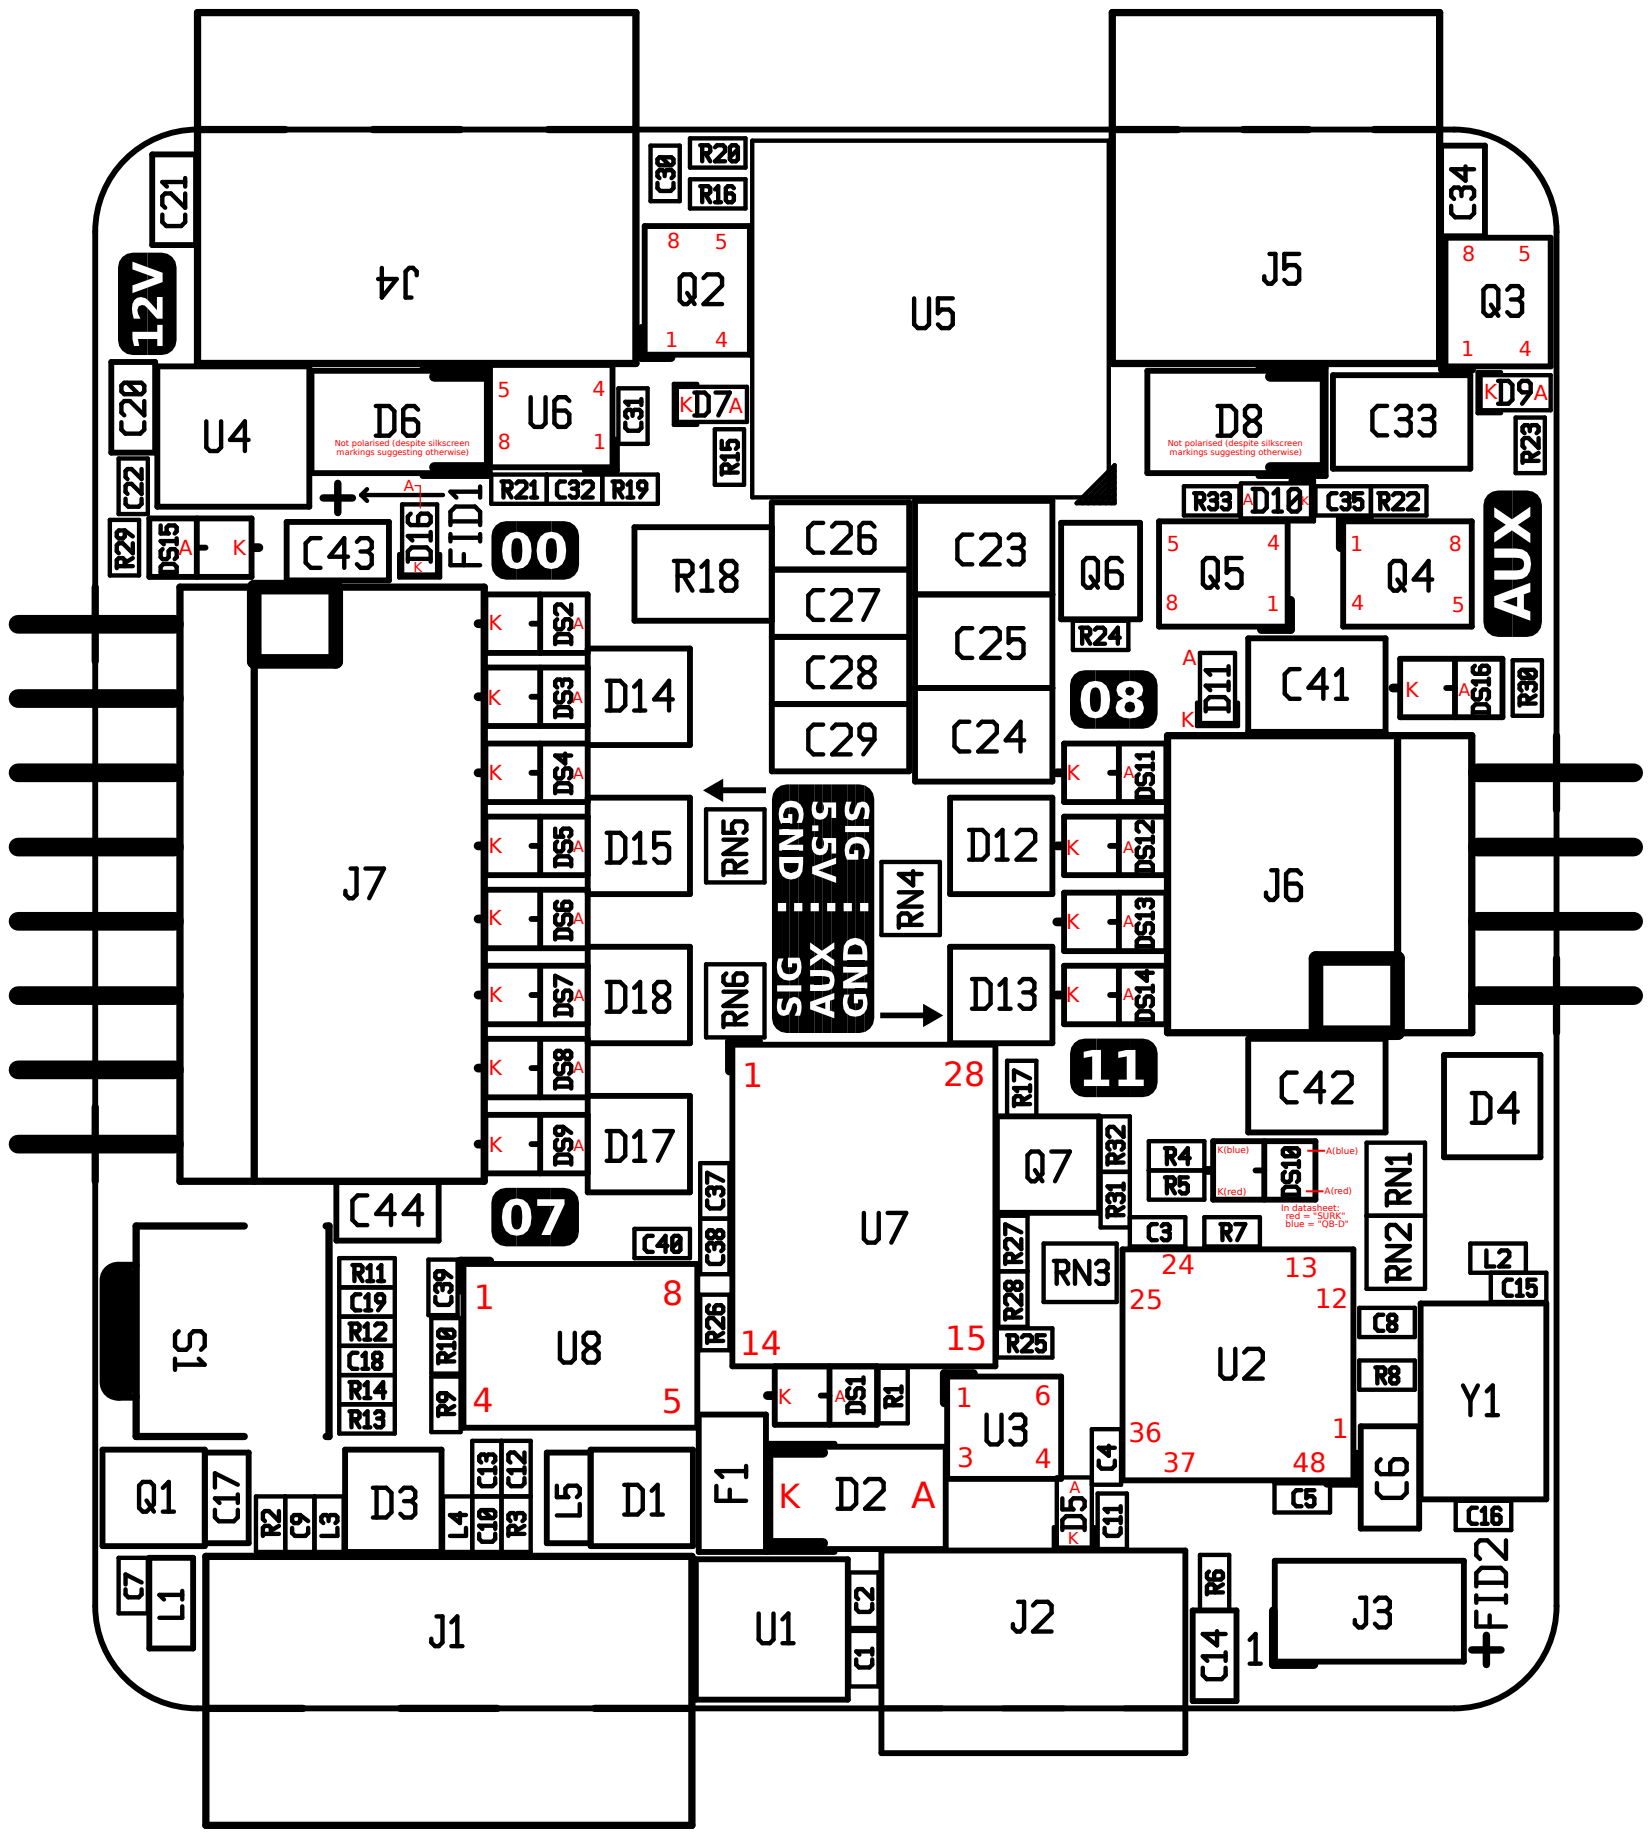
[picture p17: page 1]
K(blue); K(red); A(blue); A(red); In datasheet: red = "SURK" blue = "QB-D"

Not polarised (despite silkscreen markings suggesting otherwise) | 5 8 | 4 A 1 | Not polarised (despite silkscreen markings suggesting otherwise) | K A K
