sourcebots/kit-manufacture-2019/(commit log)

2019-02-04 Initial commit: add gerbers
    [motor.bottom.gbr, motor.bottommask.gbr, motor.bottomsilk.gbr, motor.fab.gbr, motor.group2.gbr, motor.group3.gbr, motor.outline.gbr, motor.top.gbr]
2019-02-04 Export top silkscreens to create placement diagrams
2019-02-04 Update servo board gerbers to include debranding of bottom silk
    Closes #1.
    [servo.bottom.gbr, servo.bottommask.gbr, servo.bottomsilk.gbr, servo.fab.gbr, servo.group2.gbr, servo.group3.gbr, servo.outline.gbr, servo.top.gbr]
2019-02-11 servo placement diagram: hide temporary "done" layer and make all annotations the same colour
2019-02-11 servo polarities: tweak colours
2019-02-11 servo polarities: finish up last few components
2019-02-11 Add servo board schematic PDF
2019-02-11 Add power board polarities
2019-02-11 Add power board schematic
2019-02-11 Add motor board schematic
2019-02-11 Add motor board polarities
2019-02-11 Minor stylistic fix on power polarity diagram
2019-02-11 Layer 5 is an annotation (presumably to satisfy a DRC checker or something) and is not relevant to fabrication
    [power.group5.gbr]
2019-02-11 Remove mounting holes from motor coords file
2019-02-11 Add board specifications
    Closes #6
2019-02-18 Add per-board BOMs
    Closes #2.
    [motor-bom.xlsx, power-bom.xlsx, servo-bom.xlsx]
2019-02-18 Set soldermask and silkscreen colours
2019-03-04 Add board dimensions
    Measured using DirtyPCBs' web interface.
2019-03-09 Rename README so that its obviously a text file
    We know what markdown is but sales employees at PCB suppliers might not.
2019-03-09 Remove unpopulated components from power-coords.txt
2019-03-09 Add number of different types of component on each board
    Suppliers are interested in this.
2019-05-27 Add zip files for gerbers
2019-05-27 Regenerate BOMs from bomtool
    [motor-bom.xlsx, power-bom.xlsx, servo-bom.xlsx]
2019-07-09 Add fiducial markers to PCB layouts
2019-07-09 Regenerate gerbers
    [motor.bottom.gbr, motor.bottommask.gbr, motor.bottomsilk.gbr, motor.fab.gbr, motor.group2.gbr, motor.group3.gbr, motor.outline.gbr, motor.top.gbr]
2019-07-09 Remove press-fit connectors from coords file since they will not be populated.
2019-07-10 Update submodules to include dummy pin in fiducial footprint
2019-07-10 Reformat coordinate files to be expected format
    https://uk.beta-layout.com/pcb/technology/assembly_guide.html, section 3
2019-07-11 Use full part spec for the "value" column of the coordinate file
    This makes it easier to distinguish between parts with the same
    resistance/capacitance value but different packages or other
    specifications e.g. voltage.
2019-07-11 Update BOMs
    [motor-bom.xlsx, power-bom.xlsx, servo-bom.xlsx]
2019-08-06 Redraw power board polarity diagram for clarity
2019-08-08 Redraw motor board polarity diagram
2020-02-11 Update servo board BOM
    Generated by bomtool - see recent commit history on that repo.
    [servo-bom.xlsx]
2020-02-22 Update servo board polarity diagram
2020-02-22 Fix typo (power -> servo)
2020-11-26 Replace requested parts with equivalents. Note some original parts appear to be back in stock
    [servo-bom.xlsx]
2020-11-26 Add mouser link for U2 since Farnell and Mouser both have limited stock
    [servo-bom.xlsx]
2020-11-29 Change F1 to better part suggestion
    [servo-bom.xlsx]
